Anubys6/ExpendeX-Smart-Vending-FIME/06_RENDERS_OFICIALES_Y_COMERCIALES/Img16_CAD_Fusion360_Vista_Posterior_Matriz_Motorreductores_Cableado.png

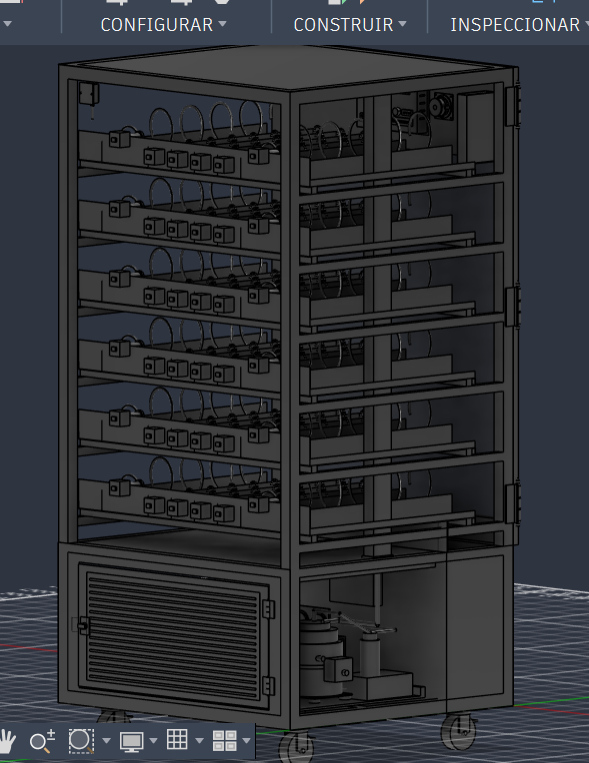
06_RENDERS_OFICIALES_Y_COMERCIALES/Img16_CAD_Fusion360_Vista_Posterior_Matriz_Motorreductores_Cableado.png
