Anubys6/ExpendeX-Smart-Vending-FIME/05_PLATAFORMA_WEB_DUAL/user_interface_admin/images/coca_cola_sin_azucar.jpg

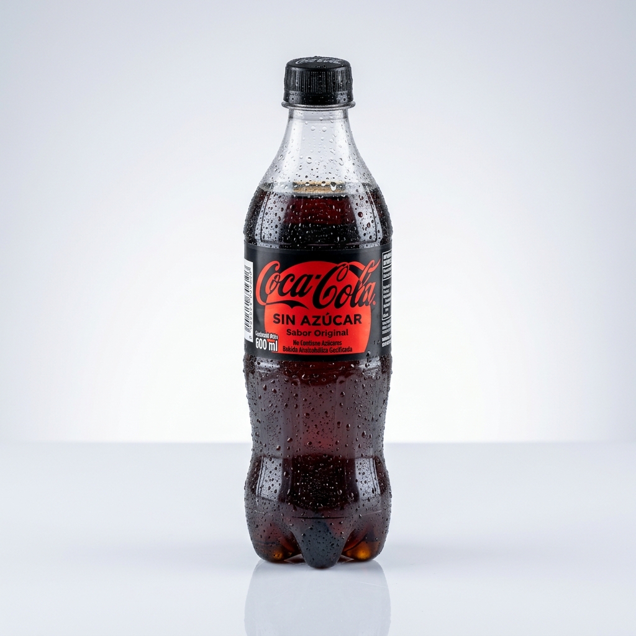
05_PLATAFORMA_WEB_DUAL/user_interface_admin/images/coca_cola_sin_azucar.jpg
