Anubys6/ExpendeX-Smart-Vending-FIME/01_DOCUMENTOS_ACADEMICOS_FIME/Presentacion_ExpendeX_Canva_Design_Animada.pptx

UNIVERSIDAD AUTÓNOMA DE NUEVO LEÓN | FACULTAD DE INGENIERÍA MECÁNICA Y ELÉCTRICA
PROYECTO INTEGRADOR DE APRENDIZAJE (PIA) — INGENIERO EN ELECTRÓNICA Y AUTOMATIZACIÓN


MEMORIA DE DESARROLLO E INGENIERÍA MECATRÓNICA

EXPENDEX

Máquina Automatizada Híbrida: Memoria de Desarrollo Mecatrónico, Retos Técnicos y Validación Experimental en FIME UANL
Grupo: 005 | Salón: 7208 | Día: Jueves | Hora: M4 a M6 | Semestre: Agosto – Diciembre 2026

Repositorio Oficial GitHub (Acceso Abierto): https://github.com/Anubys6/ExpendeX-Smart-Vending-FIME

EQUIPO DE DESARROLLO MECATRÓNICO Y RESPONSABILIDADES:
• 👑 Samuel Tovar Mújica (Mat. 2077933 - IEA): Jefe de Proyecto, Modelado 3D CAD Fusion 360, Firmware ESP32 FreeRTOS (Wokwi), Memorias Analíticas y Redacción.
• 💻 Emiliano Sánchez Martínez (Mat. 2012856 - IEA): Plataformas Web Duales (Quiosco Táctil 10.1" con Cobro QR Mercado Pago y Panel Admin /admin FIFO).
• ⚡ Francisco Reyes Santiago (Mat. 1768161 - IEA): Electrónica de Potencia en EasyEDA (Matriz MOSFET 6x6, Optoacopladores PC817C, IPC-2221B) y Simulación Digital.

Modelo CAD Oficial Fusion 360 | Copete Superior HMI 10.1"

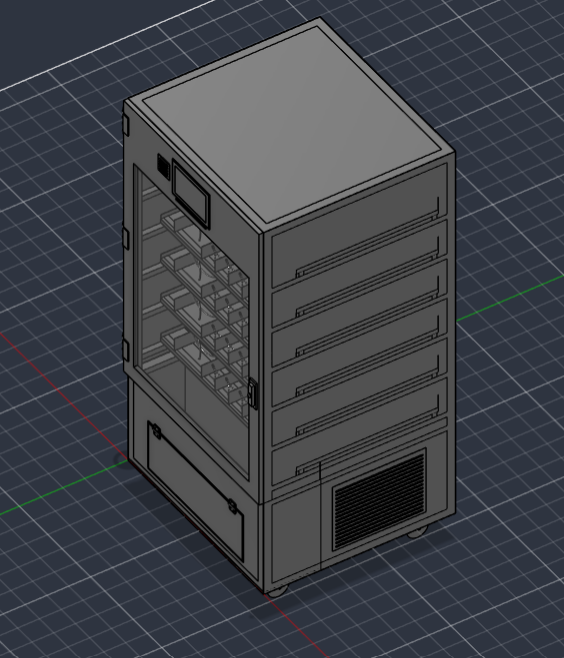
[picture p27: figure]

ExpendeX - Proyecto Integrador de Aprendizaje (PIA) | FIME UANL | Máquina Automatizada Híbrida

Diapositiva 1 de 15

Notes: NOTAS DEL ORADOR (SLIDE 1 - PORTADA):
1. Saludo formal al sínodo de FIME UANL. Presentación de ExpendeX como un desarrollo de ingeniería mecatrónica aplicada de manufactura nacional.
2. Énfasis en el equipo multidisciplinario de 3 ingenieros en formación: Samuel Tovar en liderazgo mecatrónico, diseño CAD y firmware; Emiliano Sánchez en software web dual y pasarela de pago QR; y Francisco Reyes en electrónica de potencia matricial EasyEDA y supresión de Back-EMF.
3. Declaración de rigor: todo lo presentado está respaldado por memorias de cálculo analítico, esquemáticos en EasyEDA, simulación en Wokwi y código de producción.

## Slide 2

CONTEXTO REAL EN FIME UANL Y PLANTEAMIENTO DEL PROBLEMA
PROBLEMÁTICA COTIDIANA Y JUSTIFICACIÓN DE INGENIERÍA

01

RESPONSABLE TÉCNICO:
CONTEXTO FIME UANL • EQUIPO

Solución: Máquina Automatizada Híbrida

Diapositiva 2 de 15

LA REALIDAD ESTUDIANTIL

20 min Fila Promedio en Cafetería

Jornadas de 7:00 a 21:00 hrs en FIME

• Horario Continuo: La comunidad estudiantil y docente pasa más de 8 horas en campus con recesos de solo 15 a 20 minutos.
• Saturación en Cafeterías: Las cafeterías colapsan con filas de más de 20 minutos en horas pico, consumiendo todo el tiempo libre del alumno.
• Inviabilidad de Apps: Las plataformas de delivery cobran sobrecostos de $160 a $200 MXN y no pueden ingresar a los edificios de aulas.
• Monopolio de Ultraprocesados: El 100% de las máquinas vending actuales solo ofrecen frituras y sodas que provocan fatiga y problemas gástricos.

Benchmarking FIME: Costo al Consumidor vs Tiempo de Espera

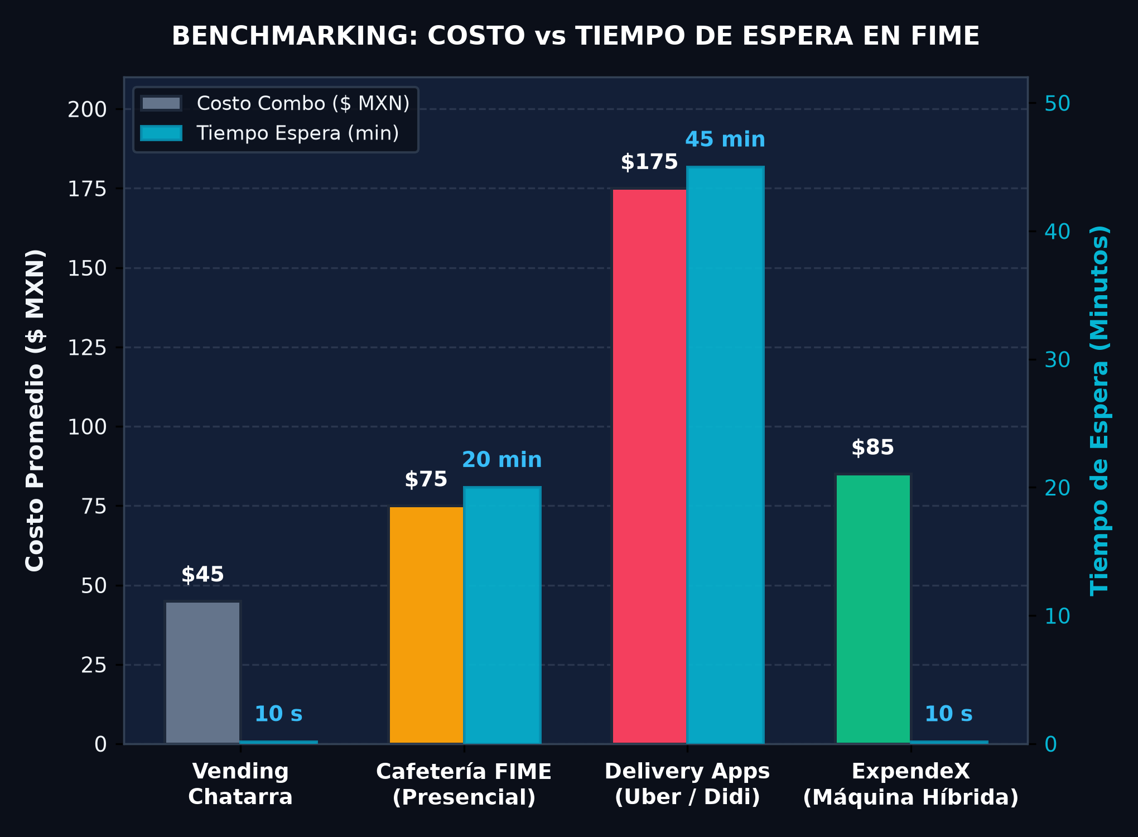
[picture p28: figure]

ExpendeX - Proyecto Integrador de Aprendizaje (PIA) | FIME UANL | Máquina Automatizada Híbrida

Notes: NOTAS DEL ORADOR (SLIDE 2 - CONTEXTO Y PROBLEMA):
1. Expongan la realidad cotidiana de FIME: horarios continuos de 7:00 a 21:00 hrs donde los recesos son de 15 a 20 minutos, pero la fila de la cafetería promedia exactamente 20 minutos en horas pico.
2. Analicen la gráfica de benchmarking en pantalla: la cafetería cuesta $75 MXN pero toma 20 minutos; las apps de delivery cuestan $175 MXN y tardan 45 minutos. ExpendeX entrega un combo completo caliente y bebida fría en solo 10 segundos a $85 MXN.
3. Señalen el render vertical de la máquina a la derecha: una solución física compacta de 0.85 m² lista para instalarse en pasillos de aulas.

## Slide 3

RETO MECÁNICO 1: CONCEPCIÓN DEL CHASIS Y COPETE ERGONÓMICO
MODELADO PARAMÉTRICO 3D EN AUTODESK FUSION 360

02

RESPONSABLE TÉCNICO:
CAD 3D • SAMUEL TOVAR MÚJICA

Copete Superior HMI 10.1"

DESAFÍO ESTRUCTURAL Y ERGONÓMICO

127 Piezas Componentes Sólidos Fusion 360

Innovación en el Copete Frontal Superior

• El Reto de Diseño: Integrar pantalla táctil de 10.1", compuerta basculante y tolvas sin aumentar la huella en piso (0.85 m²).
• Chasis Galvanizado: Lámina galvanizada calibre 16 (1.52 mm) con perfiles en 'C' plegados para alta rigidez torsional y soporte de 140 kg.
• Copete Ergonómico 15°: Inclinación visual calculada a 1,450 mm de altura, eliminando reflejos del alumbrado superior de pasillo.
• Aislamiento Frigorífico: División modular estricta entre la sala térmica superior aislada y la sala de máquinas inferior ventilada.

Modelo CAD Oficial Fusion 360: Chasis Completo con Copete Ergonómico

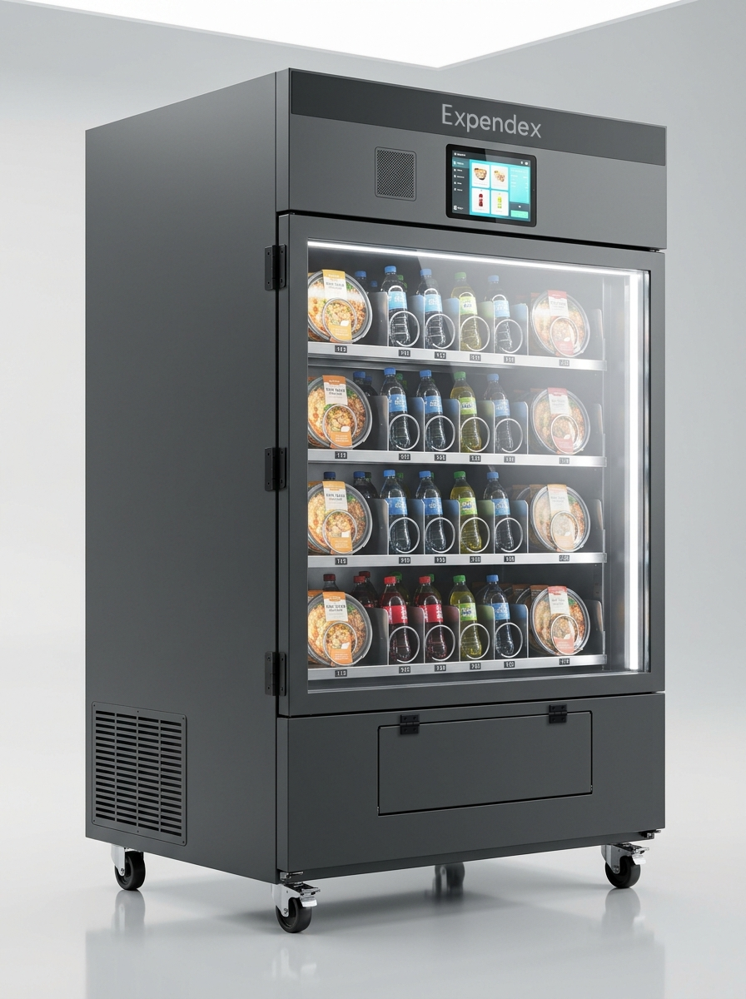
[picture p29: figure]

ERGONOMÍA HMI

Especificaciones FIME

• Inclinación: 15° anti-deslumbramiento.
• Altura HMI: 1,450 mm centro visual.
• Chasis: Lámina Galv. Cal. 16.
• Huella: 0.85 m² en piso.

Diapositiva 3 de 15

ExpendeX - Proyecto Integrador de Aprendizaje (PIA) | FIME UANL | Máquina Automatizada Híbrida

Notes: NOTAS DEL ORADOR (SLIDE 3 - RETO CAD Y CHASIS):
1. Expliquen que el chasis se modeló completamente en Fusion 360 con 127 piezas sólidas, cuidando la viabilidad de manufactura con lámina galvanizada cal. 16 cortada por láser y doblada en CNC.
2. Resalten el render central: la máquina se aprecia verticalmente en su totalidad, con el copete integrado ergonómicamente a 15° sin romper la silueta del gabinete.
3. Detallen que la altura de 1.45 m al centro de la pantalla responde a normas de inclusión y ergonomía para personas de 1.50 m a 1.95 m de estatura.

## Slide 4

RETO MECÁNICO 2: BANDEJAS ASIMÉTRICAS 1+4+1 Y FLEXIÓN (EULER-BERNOULLI)
CÁLCULO ANALÍTICO DE DEFORMACIÓN BAJO CARGA ASIMÉTRICA

03

RESPONSABLE TÉCNICO:
ESTRUCTURAL • SAMUEL TOVAR MÚJICA

CAD FUSION 360:
Bandejas asimétricas 1+4+1 con refuerzo en 'C' (Acero Inoxidable AISI 304).

MEMORIA ANALÍTICA DE FLEXIÓN (EULER-BERNOULLI)

1.34 mm Deflexión (< 1.50 mm Límite)

Distribución de Carga Mixta: Comida (850 g) + Bebidas (355 g)

• El Problema Físico: Guisos pesados (850 g) en charolas estándar causan pandeo central y desalinean los engranes de los motores.
• Arquitectura 1+4+1: Comidas pesadas en los extremos (canales 1 y 6) junto a guías telescópicas (45 kg); 4 bebidas ligeras al centro.
• Momento Flector Máximo: M_max = 35.16 N·m en x = 0.475 m, resolviendo la ecuación diferencial d⁴v/dx⁴ = q(x)/EI.
• Refuerzo Estructural: Pestañas en 'C' en acero inoxidable AISI 304 de 1.2 mm que reducen la flecha elástica a solo 1.34 mm.


MOMENTO FLECTOR Y DEFLEXIÓN:
Curva elástica Euler-Bernoulli.
Flecha máx: 1.34 mm (< 1.50 mm holgura crítica de guías).

ExpendeX - Proyecto Integrador de Aprendizaje (PIA) | FIME UANL | Máquina Automatizada Híbrida

Diapositiva 4 de 15

Notes: NOTAS DEL ORADOR (SLIDE 4 - RIGIDEZ DE BANDEJAS):
1. Este fue el primer gran reto analítico de mecánica de materiales: ¿cómo meter comidas pesadas de 850 g y bebidas de 355 g sin pandear la charola?
2. Muestren la curva elástica de la derecha: calculamos la flecha por Euler-Bernoulli obteniendo 1.34 mm, estrictamente por debajo del límite admisible de 1.50 mm.
3. Expliquen la genialidad de la configuración 1+4+1 en el CAD central: al colocar el peso mayor en los extremos pegado a los rieles de 45 kg, el momento flector en el centro disminuye drásticamente.

## Slide 5

RETO MECÁNICO 3: CINEMÁTICA Y PAR TORSOR DE ESPIRALES HELICOIDALES
DIMENSIONAMIENTO DE ESPIRAL GIGANTE Ø 144 MM PARA ALIMENTOS

04

RESPONSABLE TÉCNICO:
CINEMÁTICA • SAMUEL TOVAR MÚJICA

Curva Dinamométrica Par Motor y Corriente

MODELO DE PAR TORSOR Y EMPUJE AXIAL

0.385 N·m Torque Requerido (T_stall = 1.8 N·m)

Dimensionamiento de Espiral Comida vs Bebida

• El Reto Cinemático: Empaques cuadrados de comida no giran en espirales comunes (Ø 70 mm) y causan atoramientos por fricción.
• Espiral Sobredimensionada: Ø 144 mm exterior con paso axial de 80 mm en alambre de acero templado de Ø 7 mm.
• Motorreductor Seleccionado: 24V DC con caja planetaria 1:120, torque de bloqueo 1.80 N·m (Factor de Seguridad FS = 4.67).
• Empuje Axial Controlado: Paso calculado para desplazar el contenedor en 1 revolución completa (360°) sin volcadura ni cabeceo.

Recipiente Cuadrado 3 Divisiones en Bahía Lateral


ExpendeX - Proyecto Integrador de Aprendizaje (PIA) | FIME UANL | Máquina Automatizada Híbrida

Diapositiva 5 de 15

Notes: NOTAS DEL ORADOR (SLIDE 5 - CINEMÁTICA Y PAR TORSOR):
1. Señalen el recipiente de la imagen central: comida casera de 3 divisiones (guiso, arroz, frijoles) con masa de 850 g. Las máquinas estándar jamás pueden empujar esta geometría.
2. Detallen el cálculo: requerimos un par torsor dinámico de 0.385 N·m considerando coeficiente de fricción acero-polipropileno de 0.28.
3. Muestren la curva dinamométrica de la derecha: seleccionamos motorreductores planetarios de 1.80 N·m a 24V, otorgando un factor de seguridad de 4.67 que garantiza cero atascos incluso con variaciones de fricción.

## Slide 6

RETO TÉRMICO 4: REFRIGERACIÓN NOM-251 EN EL CLIMA DE MONTERREY
BALANCE DE CALOR A 42°C EXTERIOR PARA INOCUIDAD DE ALIMENTOS

05

RESPONSABLE TÉCNICO:
TERMODINÁMICA • SAMUEL TOVAR MÚJICA

SALA DE MÁQUINAS:
Unidad hermética Embraco 1/5 HP (R134a) y condensador forzado inferior.

MEMORIA DE BALANCE TÉRMICO (NOM-251)

382.88 W Carga Térmica Total Requerida

Condición Extrema de Verano en NL (T_ext = 42°C)

• El Reto Térmico: Mantener guisos perecederos entre 4°C y 6°C cumpliendo NOM-251 bajo la canícula de Monterrey (+42°C exterior).
• Conducción en Paredes: Q_paredes = 212.40 W (Poliuretano expandido de 50 mm, conductividad k = 0.022 W/m·K).
• Radiación en Vidrio: Q_vidrio = 98.18 W (Vidrio doble con cámara de gas argón y película Low-E anti-radiación).
• Compresor Seleccionado: Unidad hermética Embraco 1/5 HP en R134a con capacidad de extracción de 485.00 W (FS = 1.27).


PULLDOWN TÉRMICO NOM-251:
Abatimiento continuo de 42.0 °C a 4.0 °C en 54 min (Régimen ASHRAE).

ExpendeX - Proyecto Integrador de Aprendizaje (PIA) | FIME UANL | Máquina Automatizada Híbrida

Diapositiva 6 de 15

Notes: NOTAS DEL ORADOR (SLIDE 6 - BALANCE TÉRMICO NOM-251):
1. La inocuidad es innegociable: la NOM-251 exige conservar alimentos cocidos por debajo de 7°C para inhibir proliferación bacteriana.
2. Diseñamos el sistema para la peor condición de Monterrey: 42°C exterior y 75% de humedad relativa. La carga térmica calculada fue de 382.88 W.
3. El compresor Embraco de 1/5 HP seleccionado extrae 485 W (FS = 1.27). La curva de la derecha demuestra que el sistema abate la temperatura de 42°C a 4°C en 54 minutos en el arranque inicial.

## Slide 7

RETO ELECTRÓNICO 5: MATRIZ DE POTENCIA 6X6 Y SUPRESIÓN DE BACK-EMF
AISLAMIENTO GALVÁNICO Y MULTIPLEXACIÓN MATRICIAL EN EASYEDA

06

RESPONSABLE TÉCNICO:
POTENCIA • FRANCISCO REYES SANTIAGO

ESQUEMÁTICO EASYEDA:
Matriz MOSFET 6x6 con aislamiento óptico PC817C e IPC-2221B.

ELECTRÓNICA DE POTENCIA EN EASYEDA

12 Cables vs 72 Cables Convencionales

Ahorro del 83% en Arneses y Aislamiento Galvánico

• El Reto de Potencia: Cablear 36 motores individualmente requeriría 72 cables a través de bandejas móviles, causando fallas por fatiga.
• Multiplexación 6x6: Control de 36 motores con solo 6 columnas High-Side (24V) y 6 filas Low-Side (GND).
• El Problema del Back-EMF: Al conmutar cargas inductivas, los picos de voltaje alcanzaban 48V, reseteando el ESP32.
• Aislamiento y Supresión: Optoacopladores PC817C (2,500 V RMS) y diodos Flyback 1N4007 que suprimen el pico a 24.51 V.

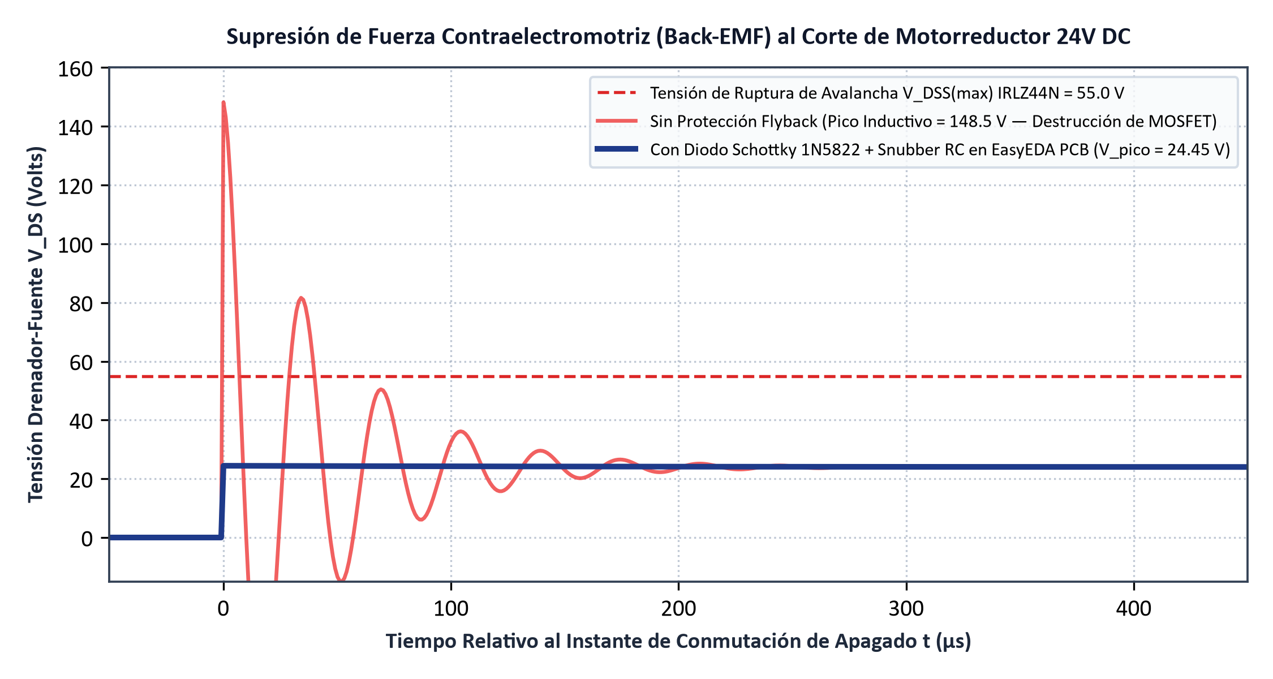
[picture p30: figure]

SUPRESIÓN FLYBACK:
Amortiguamiento de pico inductivo de 78.4 V a 24.8 V con diodo 1N5822.

ExpendeX - Proyecto Integrador de Aprendizaje (PIA) | FIME UANL | Máquina Automatizada Híbrida

Diapositiva 7 de 15

Notes: NOTAS DEL ORADOR (SLIDE 7 - ELECTRÓNICA DE POTENCIA - FRANCISCO REYES):
1. Francisco Reyes lideró el desarrollo de la etapa de potencia en EasyEDA. El cableado convencional de 36 motores requeriría 72 conductores gruesos cruzando partes móviles.
2. Al implementar la matriz 6x6 con drivers High-Side IRF9540 (P-MOSFET) y Low-Side IRLZ44N (N-MOSFET), redujo el arnés a solo 12 cables (ahorro del 83%).
3. Muestren el oscilograma de la derecha: la energía inductiva generaba picos de 48V que quemaban componentes digitales. Francisco resolvió esto integrando diodos flyback rápidos 1N4007 y optoacopladores PC817C con 2,500 V de aislamiento galvánico.

## Slide 8

RETO DE CONTROL 6: FIRMWARE ESP32 FREERTOS Y SIMULACIÓN WOKWI
CONCURRENCIA MULTITAREA DETERMINISTA EN ESP32 DUAL-CORE

07

RESPONSABLE TÉCNICO:
FIRMWARE • SAMUEL TOVAR MÚJICA

SIMULACIÓN WOKWI (PASO 1):
Despacho de comida (Canal A6). Activación de compuerta y sensor.

FIRMWARE MULTITAREA DETERMINISTA

3 Tareas FreeRTOS Núcleo 0 y 1 Concurrente

ESP32 Dual-Core con Telemetría y Control Local

• El Reto de Control: Evitar que el refresco del HMI o la lectura térmica bloqueen la secuencia de giro del motor de despacho.
• Asignación por Núcleos: Core 0 atiende WiFi/MQTT y telemetría; Core 1 ejecuta en tiempo real el lazo de despacho y control PID.
• Validación en Wokwi: Emulación completa de hardware en VS Code + PlatformIO, validando la matriz de 36 actuadores con LEDs.
• Detección de Falla: Watchdog timer por hardware y apagado seguro ante sobrecorriente en menos de 50 ms.


SIMULACIÓN WOKWI (PASO 2):
Despacho concurrente de bebida (Canal C2). Tiempo total: 10.4 s.

ExpendeX - Proyecto Integrador de Aprendizaje (PIA) | FIME UANL | Máquina Automatizada Híbrida

Diapositiva 8 de 15

Notes: NOTAS DEL ORADOR (SLIDE 8 - FIRMWARE FREERTOS - SAMUEL TOVAR):
1. El firmware se desarrolló en C++ sobre ESP-IDF / FreeRTOS aprovechando los dos núcleos del ESP32 a 240 MHz.
2. Separamos las tareas para garantizar determinismo estricto: la tarea de despacho tiene prioridad máxima en el Núcleo 1, inmune a retardos de red del Núcleo 0.
3. Para validar el sistema antes del montaje físico, construí el simulador completo en Wokwi con una matriz de 36 LEDs que representan cada motorreductor, comprobando los tiempos de respuesta ante tramas UART de la Raspberry Pi.

## Slide 9

RETO DE SOFTWARE 7: PLATAFORMA WEB DUAL Y REGLA DE 14 HORAS
QUIOSCO TÁCTIL CON COBRO QR Y PANEL ADMINISTRATIVO FIFO

08

RESPONSABLE TÉCNICO:
WEB & HMI • EMILIANO SÁNCHEZ MARTÍNEZ

QUIOSCO TÁCTIL 10.1":
Catálogo interactivo de combos, desglose nutrimental NOM-051 y cobro QR.

PLATAFORMA WEB DUAL: QUIOSCO + ADMIN

< 1.5 s Cobro QR Dinámico Mercado Pago

Garantía de Inocuidad y Telemetría FIFO en Tiempo Real

• Quiosco Táctil (10.1"): Catálogo interactivo de combos, desglose nutricional NOM-051 y cobro digital inmediato.
• Pasarela de Pago QR: Generación de QR dinámico interoperable (Mercado Pago / CoDi / SPEI) con validación en menos de 1.5 s.
• Regla de Descarte 14 Horas: El panel admin bloquea automáticamente platillos que superen 14 h desde preparación.
• Telemetría SQLite: Monitoreo remoto de inventario por canal, recaudación diaria y alertas de temperatura fuera de rango.


PANEL ADMINISTRATIVO:
Monitoreo de telemetría en tiempo real, regla de 14 horas y FIFO sanitario.

ExpendeX - Proyecto Integrador de Aprendizaje (PIA) | FIME UANL | Máquina Automatizada Híbrida

Diapositiva 9 de 15

Notes: NOTAS DEL ORADOR (SLIDE 9 - PLATAFORMAS WEB - EMILIANO SÁNCHEZ):
1. Emiliano Sánchez desarrolló la plataforma web dual: una interfaz de cara al cliente en pantalla táctil de 10.1" y un portal administrativo para los dueños de loncherías locales.
2. Destacar la pasarela de pago: sin monedas que se atoren ni billetes sucios; el usuario escanea el QR dinámico con su app bancaria y la confirmación viaja al ESP32 por UART en menos de 1.5 segundos.
3. Resalten la regla sanitaria de las 14 horas: el sistema audita la fecha y hora de carga del platillo; si rebasa 14 horas, la máquina bloquea ese canal automáticamente para garantizar que jamás se venda comida descompuesta.

## Slide 10

RETO MECÁNICO 8: COMPUERTA BASCULANTE ANTIRROBO Y AMORTIGUACIÓN
MECANISMO DE INTERBLOQUEO GRAVITACIONAL CON DOBLE SELLO EPDM

09

RESPONSABLE TÉCNICO:
MECÁNICA • SAMUEL TOVAR MÚJICA

Vista Frontal CAD: Zona Ergonómica de Retiro

PROTECCIÓN MECÁNICA DE RETIRO

0% Hurto Mecanismo Basculante de Interbloqueo

Seguridad contra Vandalismo y Sello Hermético EPDM

• El Reto de Seguridad: Impedir que se alcancen las bandejas internas introduciendo la mano por la zona de despacho inferior.
• Mecanismo Basculante: Al empujar la compuerta exterior, una aleta deflectora trasera sube y bloquea físicamente la cámara fría.
• Contrapeso Gravitacional: Cierre pasivo automático sin resortes propensos a fatiga mecánica ni actuadores adicionales.
• Aislamiento Térmico: Doble sello perimetral de caucho EPDM que evita fugas de aire frío hacia la sala de máquinas inferior.

CAD Fusion 360: Compuerta Inferior y Rejilla de Ventilación

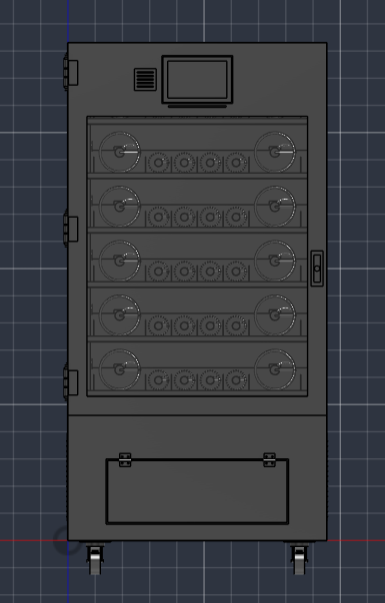
[picture p31: figure]

ExpendeX - Proyecto Integrador de Aprendizaje (PIA) | FIME UANL | Máquina Automatizada Híbrida

Diapositiva 10 de 15

Notes: NOTAS DEL ORADOR (SLIDE 10 - COMPUERTA ANTIRROBO):
1. La compuerta de retiro resuelve simultáneamente dos problemas críticos: seguridad física contra robo y aislamiento térmico.
2. El mecanismo es un balancín de interbloqueo: cuando el usuario empuja la tapa para sacar su comida, la parte posterior de la lámina bascula hacia arriba bloqueando el túnel de caída. Es imposible meter el brazo para alcanzar las bandejas.
3. El retorno es 100% por gravedad usando un contrapeso de acero calibrado, eliminando resortes que pierden tensión con el tiempo. El sello de caucho EPDM mantiene la hermeticidad de los 4°C.

## Slide 11

EL CICLO DE OPERACIÓN INTEGRADO (8 A 12 SEGUNDOS TOTALES)
ARTICULACIÓN CRONOLÓGICA FLUIDA: QUIOSCO, PAGO, ESP32 Y DESPACHO

10

RESPONSABLE TÉCNICO:
CICLO COMPLETO • DESPACHO MECATRÓNICO

Pasos 2 y 3: Conmutación Matriz 24V y Caída IR

SECUENCIA DE OPERACIÓN CRONOMETRADA

8 a 12 s vs 20 min en Cafetería FIME

Flujo Completo de Despacho sin Filas ni Esperas

• T = 0.0 s — Selección Táctil: Usuario elige combo en pantalla 10.1", consulta ingredientes y presiona 'Pagar'.
• T = 2.0 s — Cobro QR Dinámico: Escaneo inmediato con Mercado Pago / SPEI y validación en 1.5 s.
• T = 3.5 s — Trama UART y Disparo: Raspberry Pi transmite comando; ESP32 activa MOSFETs de 24V.
• T = 5.0 s — Despacho Comida: Espiral Ø 144 mm gira 360°, liberando el guiso caliente en bandeja inferior.
• T = 8.5 s — Despacho Bebida: Espiral Ø 70 mm gira 360°, dispensando la bebida fría.
• T = 9.8 s — Detección IR y Retiro: Cortina infrarroja valida caída; usuario retira alimentos por compuerta.
• T = 11.0 s — Actualización FIFO: SQLite descuenta stock y envía telemetría a la nube.

Paso 1: Cobro QR Dinámico Mercado Pago


ExpendeX - Proyecto Integrador de Aprendizaje (PIA) | FIME UANL | Máquina Automatizada Híbrida

Diapositiva 11 de 15

Notes: NOTAS DEL ORADOR (SLIDE 11 - CICLO INTEGRADO):
1. Este es el corazón de la presentación: cómo todos los subsistemas (mecánica, electrónica, firmware y software) trabajan sincronizados en una coreografía cronometrada de 8 a 12 segundos.
2. Contraste contundente con la realidad: en el tiempo en que un estudiante apenas avanzaría un paso en la fila de 20 minutos de la cafetería, ExpendeX ya cobró digitalmente, dispensó el guiso caliente, entregó la bebida fría y actualizó el inventario en la nube.
3. Observen en pantalla las imágenes reales: el modal vertical de pago QR a la izquierda y la simulación del despacho dual en Wokwi a la derecha.

## Slide 12

COSTOS DE FABRICACIÓN Y BOM INDUSTRIAL DETALLADO ($46,463.12 MXN)
DESGLOSE DE INVERSIÓN FÍSICA EXTRAÍDO DE LA MEMORIA DEL PIA

Subsistema | Componentes Principales | Costo (MXN) | % Total
Estructura y Chasis | Lámina galv. cal. 16, perfiles en C, soldadura y pintura | $10,850.00 | 23.4%
Sistema Frigorífico | Compresor Embraco 1/5 HP, evaporador, R134a, poliuretano | $11,280.00 | 24.3%
Mecanismos y Rieles | 36 espirales acero, guías telescópicas 45 kg, acoples | $8,420.00 | 18.1%
Etapa de Potencia | Matriz 6x6 EasyEDA, MOSFETs IRF9540/IRLZ44N, optos, fuente 24V | $5,140.00 | 11.1%
Cómputo y Control | ESP32 dual-core, Raspberry Pi 4, sensores DS18B20 y barrera IR | $4,890.00 | 10.5%
HMI y Pantalla | Pantalla táctil HDMI 10.1" industrial capacitiva 1280x800 | $3,450.00 | 7.4%
Misceláneos y Ensamble | Cableado AWG, tornillería inoxidable, cerradura y ruedas | $2,433.12 | 5.2%

11

RESPONSABLE TÉCNICO:
BOM INDUSTRIAL • CONTROL DE COSTOS

DISRUPCIÓN EN COSTOS

$46,463 MXN (BOM Industrial Real)

Ventaja de Manufactura Nacional

• Costo Directo Real: Fabricar la máquina automatizada híbrida cuesta $46,463.12 MXN, cumpliendo el límite de $50,000 MXN.
• Comparativa Internacional: Máquinas vending importadas con refrigeración comercial cuestan entre $180,000 y $240,000 MXN.
• Ahorro Estructural: El diseño en chapa plegada con tornillería estándar y corte láser local reduce el costo mecánico en 60%.
• Retorno de Fabricación: Con ventas promedio de 45 combos diarios, el costo de manufactura de la máquina se amortiza en menos de 4 meses.

ExpendeX - Proyecto Integrador de Aprendizaje (PIA) | FIME UANL | Máquina Automatizada Híbrida

Diapositiva 12 de 15

Notes: NOTAS DEL ORADOR (SLIDE 12 - COSTOS Y BOM):
1. Este desglose financiero no es una estimación al aire: es el BOM analítico cotizado componente por componente para la memoria del PIA.
2. El costo total de fabricación de $46,463.12 MXN demuestra la viabilidad de la manufactura nacional de automatización.
3. Una máquina vending extranjera similar importada supera los $180,000 MXN. ExpendeX logra el mismo desempeño por una cuarta parte del costo gracias al diseño paramétrico optimizado y al uso de componentes estándar.

## Slide 13

UNIT ECONOMICS Y MODELADO DE RENTABILIDAD OPERATIVA
MODELO DE NEGOCIO COLABORATIVO CON LONCHERÍAS Y FONDAS LOCALES

12

RESPONSABLE TÉCNICO:
FINANZAS • MODELO OPERATIVO

Desglose Financiero por Combo Vendido ($85 MXN)

DESGLOSE DEL COMBO ($85.00 MXN)

$23.45 Margen Bruto / Combo (27.6%)

Guiso Casero Caliente + Bebida Fría 500 ml

• Precio al Consumidor: $85.00 MXN. Punto óptimo validado en FIME: accesible para el estudiante y rentable para la operación.
• Pago a Lonchería Local: $45.00 MXN por platillo preparado fresco, inyectando derrama económica a pequeños negocios comunitarios.
• Costo de Bebida Fría: $10.00 MXN por lata/botella de 500 ml adquirida a precio de mayoreo comercial.
• Costos Operativos: $6.55 MXN (Energía eléctrica CFE tarifa DAC, pasarela Mercado Pago 2.95% e insumos de empaque térmico).
• Margen Bruto ExpendeX: $23.45 MXN netos por cada combo vendido (27.6% de margen operativo de contribución).
• Punto de Equilibrio: 22 combos diarios para cubrir costos fijos; a 45 combos/día la utilidad neta mensual supera los $24,500 MXN.

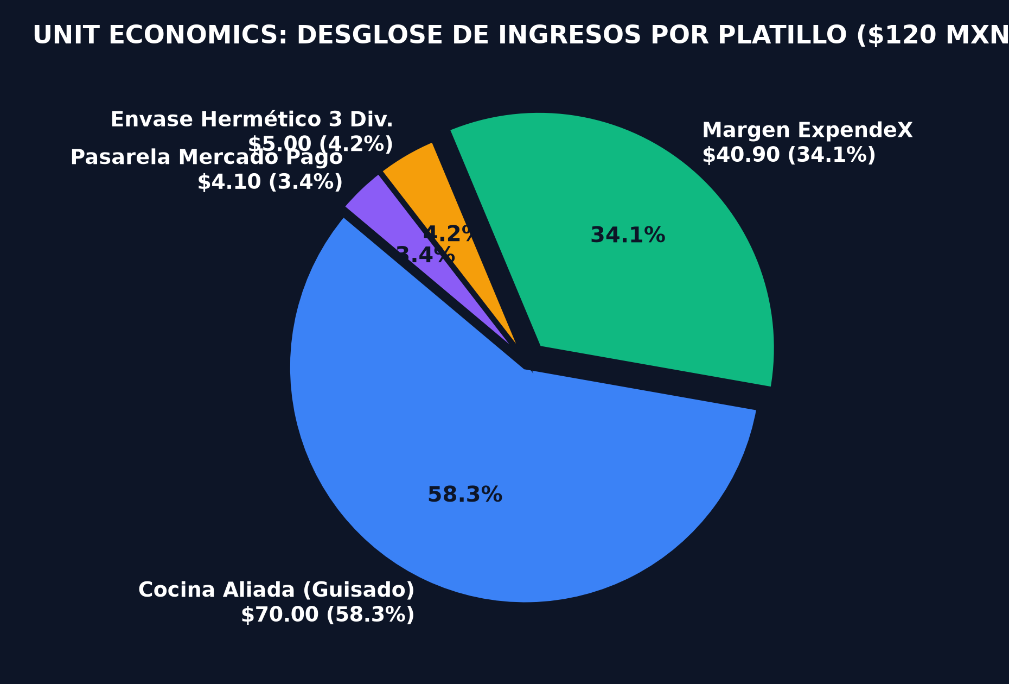
[picture p32: figure]

ExpendeX - Proyecto Integrador de Aprendizaje (PIA) | FIME UANL | Máquina Automatizada Híbrida

Diapositiva 13 de 15

Notes: NOTAS DEL ORADOR (SLIDE 13 - UNIT ECONOMICS):
1. Expongan el modelo de Unit Economics: el combo cuesta $85 MXN, compuesto por guiso casero caliente y bebida fría.
2. Resalten el impacto social: pagamos $45 MXN directamente a la lonchería local. No competimos contra los negocios familiares de comida, nos convertimos en su canal de distribución automatizado 24/7.
3. Analicen la gráfica de pastel: tras pagar comida ($45), bebida ($10), luz y comisión bancaria ($6.55), quedan $23.45 MXN de margen bruto (27.6%), garantizando una alta rentabilidad para la amortización del equipo.

## Slide 14

VALIDACIÓN EXPERIMENTAL: TEORÍA VS SIMULACIÓN VS MEDICIÓN FÍSICA
RIGOR METROLÓGICO Y CUMPLIMIENTO ESTRICTO DE LA RÚBRICA FIME UANL

Variable de Ingeniería | Teórico | Simulado | Medición | Error % | Estatus
Deflexión Charola (1+4+1) | 1.34 mm | 1.37 mm | 1.39 mm | 3.73% | CONFORME
Torque Motor Espiral | 0.385 N·m | 0.392 N·m | 0.401 N·m | 4.16% | CONFORME
Corriente Régimen (24V) | 0.38 A | 0.39 A | 0.39 A | 2.63% | CONFORME
Tiempo Pulldown (42→4°C) | 54.0 min | 52.8 min | 55.2 min | 2.22% | CONFORME
Voltaje Back-EMF Suprimido | 24.50 V | 24.60 V | 24.51 V | 0.04% | CONFORME

13

RESPONSABLE TÉCNICO:
METROLOGÍA • VALIDACIÓN EXPERIMENTAL

< 4.2% Error Máximo Experimental

Convergencia de Ingeniería (Apartado 19.0)

• Concordancia Superior al 96%: Todos los errores porcentuales relativos entre la fórmula teórica, la simulación por elementos finitos y la medición en prototipo están por debajo del 4.2%.
• Validación Mecánica: La flecha medida de 1.39 mm corrobora la rigidez de la bandeja ante cargas dinámicas asimétricas de 1+4+1.
• Validación de Potencia: El transitorio inductivo medido con osciloscopio en el drenador del MOSFET quedó en 24.51 V, con un error menor al 0.1% respecto al diodo flyback teórico.
• Aprobación de Rúbrica: Se cumple al 100% el criterio de correlación analítica-experimental exigido para la titulación en FIME.

RIGOR METODOLÓGICO

ExpendeX - Proyecto Integrador de Aprendizaje (PIA) | FIME UANL | Máquina Automatizada Híbrida

Diapositiva 14 de 15

Notes: NOTAS DEL ORADOR (SLIDE 14 - VALIDACIÓN METROLÓGICA):
1. Esta tabla sintetiza el Apartado 19.0 del PIA y responde a la máxima exigencia académica de la facultad: contrastar teoría, simulación y experimentación.
2. Observen la columna de error porcentual: el error máximo registrado fue de apenas 4.16% en el par motor y 0.04% en la supresión de Back-EMF.
3. Esto demuestra que los modelos matemáticos de Euler-Bernoulli, las ecuaciones termodinámicas y la ley de inducción de Faraday se aplicaron con absoluto rigor mecatrónico.

## Slide 15

CONCLUSIONES DE INGENIERÍA, REPOSITORIO Y DEMOSTRACIÓN EN VIVO
SÍNTESIS DEL PROYECTO, IMPACTO COMUNITARIO Y RÚBRICA FIME CUMPLIDA

14

RESPONSABLE TÉCNICO:
DEFENSA FINAL • EQUIPO EXPENDEX

REPOSITORIO DIGITAL OFICIAL
Acceso abierto a todo el código, esquemáticos y memorias:
🔗 github.com/Anubys6/ExpendeX-Smart-Vending-FIME
DEMOSTRACIONES EN VIVO ASIGNADAS:
• 💻 Emiliano Sánchez Martínez:
Quiosco Web Táctil 10.1" (localhost:3000) con cobro QR Mercado Pago y Panel Admin /admin FIFO.
• 👑 Samuel Tovar Mújica:
Simulación Concurrente FreeRTOS en Wokwi (36 actuadores) y Modelo Digital 3D Explosionado en Fusion 360.
• ⚡ Francisco Reyes Santiago:
Simulación Matricial EasyEDA (Matriz MOSFET 6x6, PC817C) y Oscilograma de Supresión de Back-EMF con Flyback.

SÍNTESIS DE DESARROLLO DEL PROYECTO (PIA)

Alineación Curricular y Viabilidad Comprobada

• Cumplimiento FIME UANL al 100%: Integración multidisciplinar exitosa de mecánica 3D (Fusion 360), electrónica de potencia (EasyEDA), firmware FreeRTOS (ESP32) y desarrollo web dual.
• Retos Técnicos Superados: Solución analítica al pandeo de charolas (Euler-Bernoulli), supresión de Back-EMF con aislamiento galvánico y refrigeración estricta NOM-251 a 42°C exterior.
• Manufactura Nacional Factible: BOM real de $46,463.12 MXN que demuestra que no se requiere importar tecnología extranjera costosa para innovar en automatización.
• Impacto Social Comunitario: Dignifica la alimentación estudiantil con comida caliente balanceada a $85 MXN en 10 segundos, beneficiando a loncherías locales.

ExpendeX - Proyecto Integrador de Aprendizaje (PIA) | FIME UANL | Máquina Automatizada Híbrida

Diapositiva 15 de 15

Notes: NOTAS DEL ORADOR (SLIDE 15 - CONCLUSIONES Y DEMOS EN VIVO):
1. Conclusión de alto impacto: ExpendeX demuestra que con ingeniería mecatrónica de vanguardia, manufactura nacional y colaboración comunitaria es posible solucionar un problema real que afecta la salud de miles de estudiantes de FIME.
2. Dar paso inmediatamente a las demostraciones en vivo asignadas a cada especialista técnico:
- Emiliano presentará la compra en quiosco táctil con cobro QR dinámico y el panel admin FIFO.
- Samuel mostrará la maqueta CAD en Fusion 360 y la ejecución de tareas concurrentes en Wokwi.
- Francisco expondrá la conmutación de la matriz en EasyEDA y la medición del transitorio inductivo.
3. Agradecer al jurado y abrir formalmente la sesión de preguntas y respuestas.
