Anubys6/ExpendeX-Smart-Vending-FIME/03_ELECTRONICA_POTENCIA_EASYEDA/potencia.html

# ExpendeX® — Electrónica de Potencia & Matriz MOSFET 6×6 (36 Motores)

Esquemático Nativo EasyEDA Raspado de LCSC + Simulador SPICE de Conmutación High-Side / Low-Side

162 Componentes LCSC Reales

⬇ Descargar Archivo Nativo EasyEDA (.json) 🚀 Abrir EasyEDA Web Editor (https://easyeda.com/editor)

## 1. Simulador Interactivo de Conmutación 6×6

Haz clic en cualquier casilla (A1..F6) para activar su par de MOSFETs (Columna High-Side +24V y Fila Low-Side GND) y ver la ruta real de corriente:

Casilla Seleccionada

A1 (Comida Gigante)

Pines ESP32 Activos

IO33 (HIGH) / IO13 (LOW)

MOSFET High-Side (+24V)

Q_COL1 (IRF9540N: ON)

MOSFET Low-Side (GND)

Q_FILA_A (IRLZ44N: ON)

Corriente de Motor (24V)

1.85 A (44.4 W)

Protección Back-EMF

D_BLK_A1 + D_FLY_A1

## 2. Cómo Abrir en EasyEDA en 10 Segundos

Paso 1: Haz clic arriba en "Descargar Archivo Nativo EasyEDA (.json)".
Paso 2: Entra a easyeda.com/editor.
Paso 3: En el menú superior ve a File ➔ Open ➔ EasyEDA... y selecciona el archivo ExpendeX_Matriz_6x6_MOSFET_EasyEDA.json.
Paso 4: Para pasar a la placa PCB y vista 3D, haz clic en Design ➔ Convert Schematic to PCB.

## 3. BOM Oficial LCSC / JLCPCB (Raspado)

Ref | Componente | Encapsulado | LCSC ID | Cant
Q_FILA_A..F | IRLZ44NPBF (N-MOS) | TO-220-3 | C20755022 | 6
Q_COL1..6 | IRF9540NPBF (P-MOS) | TO-220-3 | C18187958 | 6
U_OPTO | PC817C Optoacoplador | SOP-4 / DIP-4 | C7472816 | 12
D_BLK / FLY | 1N4007 (1000V 1A) | SOD-123FL | C2988637 | 72
M_A1..F6 | Bornera Motor 5.08mm | CONN-2P | C42377752 | 37
U_BUCK_5V | LM2596S-5.0 Buck | TO-263-5 | C51820297 | 1
U1_ESP32 | ESP32-WROOM-32 | SMD Module | C6191506 | 1

⚡ Diagrama Esquemático Interactivo de Potencia: ■ Riel +24V High-Side | ■ Retorno Low-Side GND | ■ Columnas 1 y 6 = Espiral Gigante Comida Ruta Activa: +24V ➔ Q_COL1 (IRF9540N) ➔ D_BLK_A1 ➔ MOTOR A1 ➔ Q_FILA_A (IRLZ44N) ➔ GND
