Anubys6/ExpendeX-Smart-Vending-FIME/03_ELECTRONICA_POTENCIA_EASYEDA/Reporte_Tecnico_Electronica_Potencia_ExpendeX.html

🖨️ Imprimir / Guardar como PDF

# Reporte Técnico de Electrónica de Potencia

## Matriz MOSFET 6×6, Control de Compresor 30A & Diseño de PCB

Proyecto: ExpendeX Smart Vending Machine

Institución: Facultad de Ingeniería Mecánica y Eléctrica (FIME UANL)

Controlador: ESP32-WROOM-32 (IoT & Pasarela Mercado Pago)

Alimentación: 24 VDC @ 10A (Motores) + 120VAC / 24V (Compresor 1/5 HP)

Dimensiones PCB: 260 mm × 180 mm (2 Capas FR4, Cobre 1 oz)

Actuadores Totales: 36 Motores Espiral + 1 Compresor Hermético + Fan

### 1. Arquitectura del Sistema de Potencia e Integración del Compresor

El sistema de potencia de ExpendeX comprende dos subsistemas principales gobernados de forma centralizada por el microcontrolador ESP32:

1. Matriz Ortogonal 6×6 de Motores Dosificadores (24VDC): Multiplexa 36 motores mediante 12 transistores MOSFET (6 High-Side P-MOSFET IRF9540N y 6 Low-Side N-MOSFET IRLZ44N) con aislamiento galvánico de 5 kV por optoacopladores PC817C.
2. Etapa de Refrigeración (Cámara Fría 3.0°C - 5.5°C): Conmuta un compresor hermético de refrigeración de 1/5 HP (150W) accionado mediante un relé industrial de alta corriente de 30A / 250VAC (SLA-05VDC-SL-A), protegido por una red snubber RC de absorción de transitorios inductivos y monitoreado en lazo cerrado por una sonda digital 1-Wire DS18B20.

+24V BUS ──────────┬───────────────────┬───────────────────┬─── [6 Columnas P-MOSFET IRF9540N] │ (Q_COL1) │ (Q_COL2) │ [COL_1 Bus] [COL_2 Bus] [COL_3 Bus] │ │ │ [FILA_A Bus] ──(M_A1 + 1N4007)─────(M_A2 + 1N4007)─────(M_A3 + 1N4007) ... │ │ │ GND RETORNO ───────┴─[Q_ROW_A]─────────┴─[Q_ROW_B]─────────┴─── [6 Filas N-MOSFET IRLZ44N] ───────────────────────────────────────────────────────────────────────────────────────────── ETAPA DE REFRIGERACIÓN: 120VAC L ──[RELÉ 30A (SLA-05VDC)]──┬──(COMPRESOR 1/5 HP)── 120VAC N │ [SNUBBER 100Ω + 0.1μF] │ ESP32 IO2 ──[PC817C]──[2N2222A]──[BOBINA RELÉ + 1N4007] ESP32 IO5 ──[BUS 1-WIRE]─────────[SENSOR DIGITAL DS18B20 (3.0°C - 5.5°C)]

### 2. Red Snubber y Supresión de Arco en el Compresor

Al arrancar o apagar un compresor inductivo de refrigeración, se induce un sobrevoltaje significativo ($\Delta V = L \frac{di}{dt}$) que genera arco eléctrico entre las platinas del relé. Para garantizar una vida útil superior a 200,000 ciclos:

- Red Snubber RC: Se coloca en paralelo con los contactos normalmente abiertos (NO) una resistencia de $100\,\Omega$ (2W cerámico) en serie con un condensador de película de polipropileno metalizado de $0.1\,\mu\text{F}$ clase X2 (400V).
- Ranura de Aislamiento Galvánico (Creepage Slot): En el diseño de la placa PCB se fresó una ranura pasante sin cobre de $2.0\text{ mm}$ de ancho entre los contactos de alta tensión de 120VAC y las pistas lógicas de 5V/3.3V, garantizando una rigidez dieléctrica superior a 4,000 Vrms bajo norma IEC 60950.

### 3. Asignación Completa de Pines GPIO del ESP32

Señal Lógica | Pin ESP32 | Tipo / Etapa | Componente Físico | Función en Máquina
FILA_A .. F | IO13, 12, 14, 27, 26, 25 | Low-Side (GND) | IRLZ44NPBF + PC817C | Conmuta GND a Pisos 1 a 6
COL_1 .. 6 | IO33, 32, 23, 19, 17, 16 | High-Side (+24V) | IRF9540NPBF + PC817C | Inyecta +24V a Columnas 1 a 6
COMPRESOR | IO2 | Potencia AC/DC | Relé 30A (SLA-05VDC) + Opto | Enciende/Apaga Compresor Frío
TEMP_SENS | IO5 | Sensor 1-Wire | DS18B20 (Sonda Inox) | Monitoreo Térmico con Histéresis
DROP_SENSOR | IO4 | Digital Input | Barrera Infrarroja | Detección de Caída de Producto
LCD_I2C | IO21 (SDA), IO22 (SCL) | Bus I2C | LCD 1602 con Módulo PCF8574 | Mensajes de Pago y Temperatura

### 4. Lista de Materiales (BOM) con Números de Parte Oficiales JLCPCB / LCSC

Componente | Cant. | Encapsulado | Parámetros Relevantes | Código LCSC
IRLZ44NPBF | 6 | TO-220 | N-MOSFET 55V, 47A, Vgs(th)=1.0V-2.0V, Rds=0.022Ω | C75882
IRF9540NPBF | 6 | TO-220 | P-MOSFET -100V, -19A, Rds=0.117Ω | C2599
SLA-05VDC-SL-A | 1 | THT Power Relay | Relé de Potencia 30A 250VAC, Bobina 5VDC | C12586
PC817C | 13 | DIP-4 | Optoacoplador Galvánico Viso=5000Vrms | C76953
1N4007 | 73 | DO-41 | Diodo Rectificador 1000V 1A (72 Matriz + 1 Relé) | C64898
DS18B20 | 1 | TO-92 / Sonda | Sensor Digital de Temperatura 1-Wire ±0.5°C | C74426
LM2596S-5.0 | 1 | TO-263-5 | Regulador Reductor Conmutado 24V ➔ 5V 3A | C29781
Snubber RC (100Ω/0.1μF) | 1 | Radial 400V | Supresión de Arco Eléctrico para Compresor | C14872
Borneras Motor 5.08mm | 36 | CONN-2P | Conexión Rápida de 36 Motores de Espiral | C8584
Bornera Red 7.62mm | 1 | CONN-3P | Entrada de Alimentación Compresor (L, N, PE) | C9421

### 5. Especificaciones Físicas de la Placa PCB Generada

• Dimensiones de Placa: 260.0 mm × 180.0 mm (10.2" × 7.1")
• Material: FR-4 Doble Capa (Top Layer + Bottom Layer), Grosor 1.6 mm
• Espesor de Cobre: 1 oz (35 μm) con Plano de Masa y Bus de Potencia de 2.54 mm (100 mil)
• Aislamiento Galvánico: Ranura de fresado físico de 2.0 mm (Creepage distance de 4,000 Vrms)
• Disipación Térmica: Barra de aluminio común superior para los 12 transistores TO-220
• Montaje: 4 barrenos M3 en esquinas con conexión a tierra de chasis (PE)
