Anubys6/ExpendeX-Smart-Vending-FIME/01_DOCUMENTOS_ACADEMICOS_FIME/ExpendeX_Render_CAD_Detalle_Pantalla_10pulgadas.png

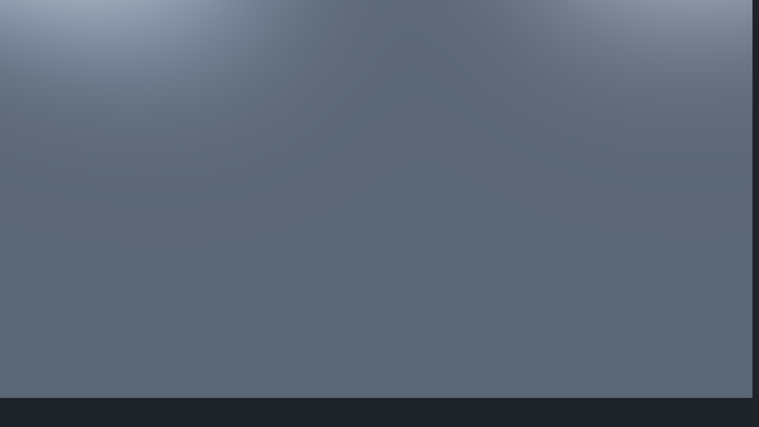
01_DOCUMENTOS_ACADEMICOS_FIME/ExpendeX_Render_CAD_Detalle_Pantalla_10pulgadas.png
