Anubys6/ExpendeX-Smart-Vending-FIME/01_DOCUMENTOS_ACADEMICOS_FIME/ExpendeX_Render_CAD_Isometrico_Derecho.png

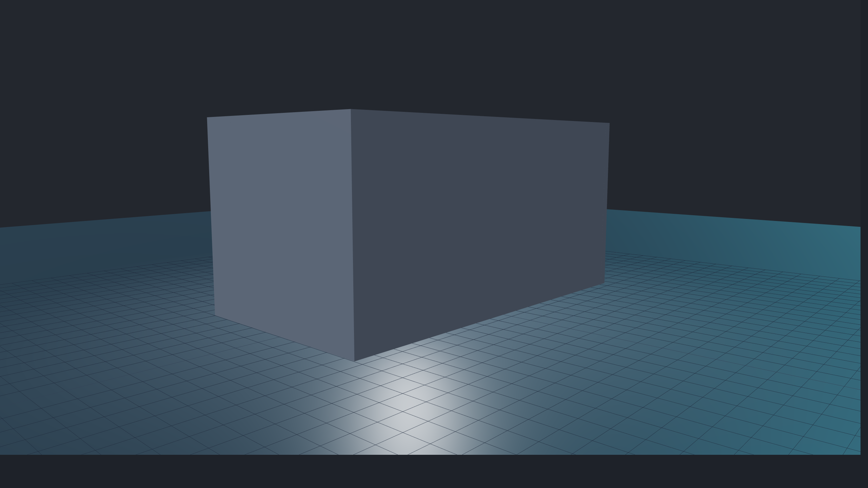
01_DOCUMENTOS_ACADEMICOS_FIME/ExpendeX_Render_CAD_Isometrico_Derecho.png
