Anubys6/ExpendeX-Smart-Vending-FIME/01_DOCUMENTOS_ACADEMICOS_FIME/ExpendeX_Render_Estudio_CAD_Oficial_1a1.png

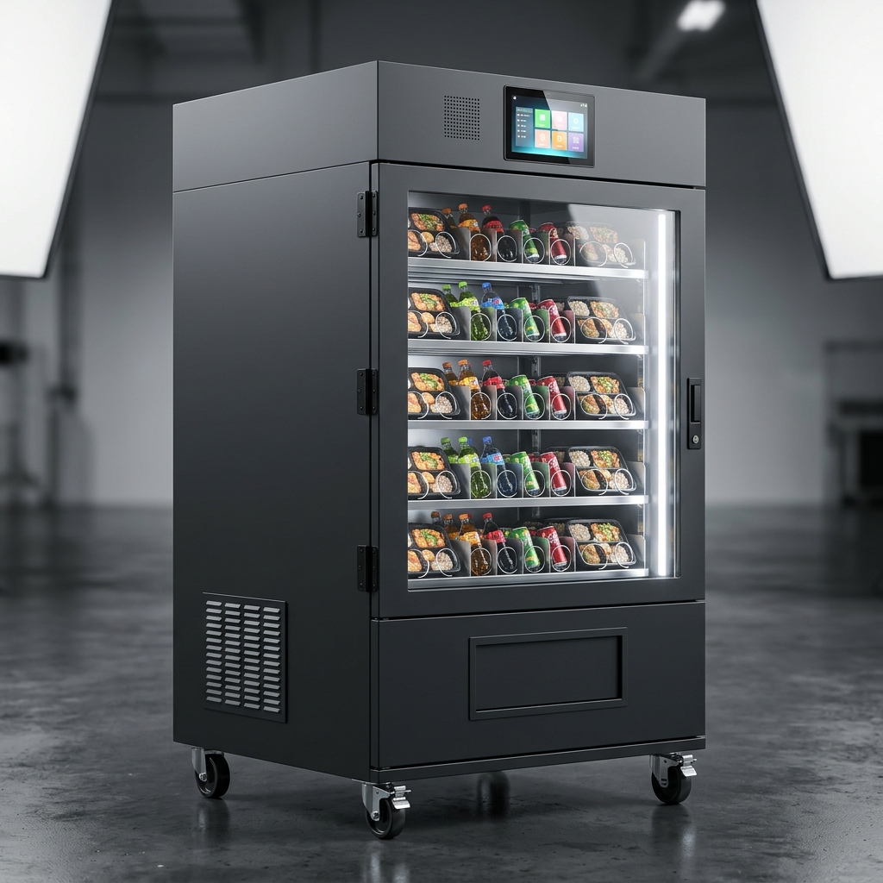
01_DOCUMENTOS_ACADEMICOS_FIME/ExpendeX_Render_Estudio_CAD_Oficial_1a1.png
