Anubys6/ExpendeX-Smart-Vending-FIME/01_DOCUMENTOS_ACADEMICOS_FIME/Img06_ExpendeX_Admin_Dashboard_Trimestral_90Dias_CurvaVentas.png

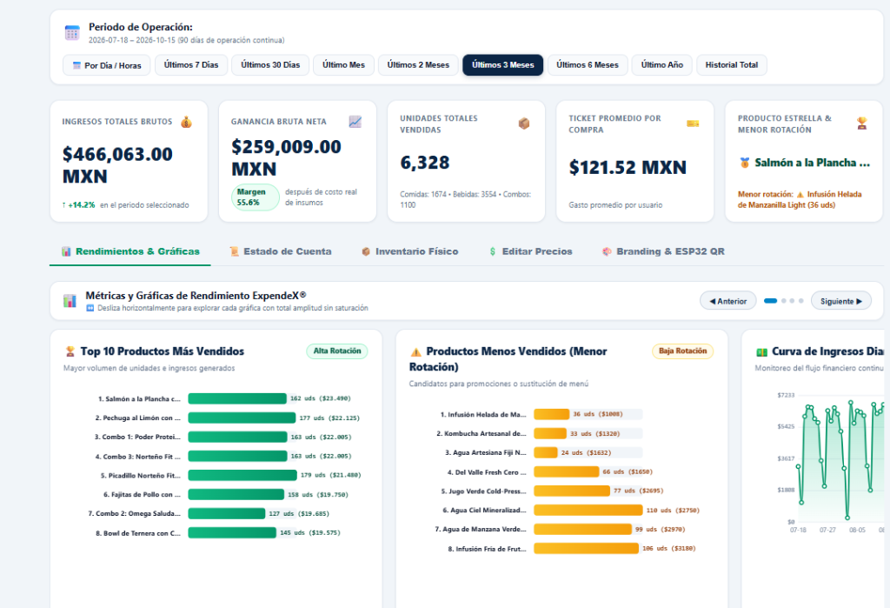
01_DOCUMENTOS_ACADEMICOS_FIME/Img06_ExpendeX_Admin_Dashboard_Trimestral_90Dias_CurvaVentas.png
