Anubys6/ExpendeX-Smart-Vending-FIME/02_MODELADO_3D_CAD/03_CAD_FUSION360_Y_AUTOCAD/Renders_Alta_Resolucion/cad_rear_isometric_structure.png

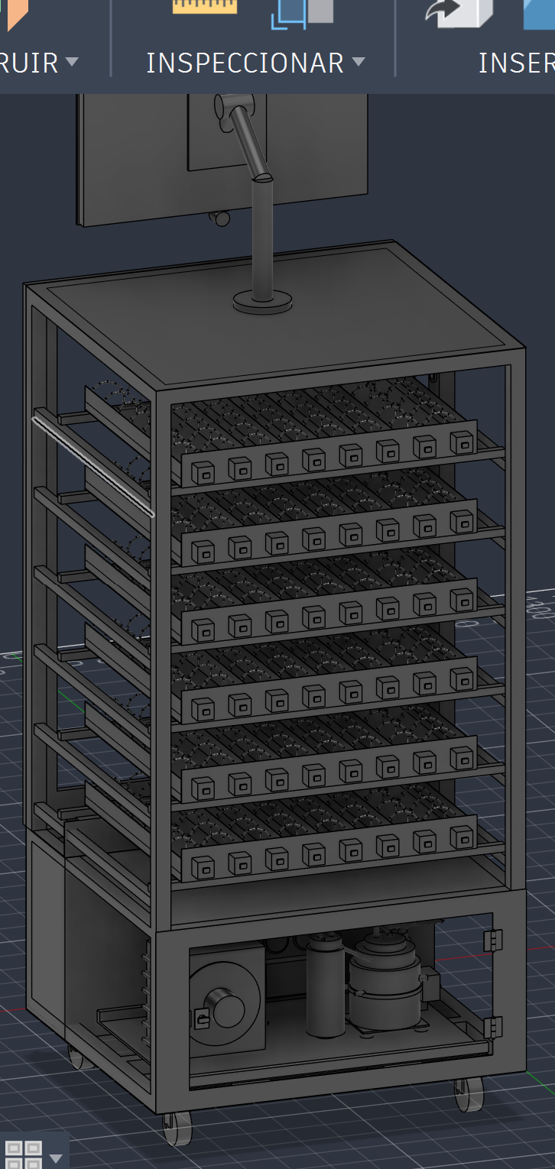
02_MODELADO_3D_CAD/03_CAD_FUSION360_Y_AUTOCAD/Renders_Alta_Resolucion/cad_rear_isometric_structure.png
