Anubys6/ExpendeX-Smart-Vending-FIME/02_MODELADO_3D_CAD/03_CAD_FUSION360_Y_AUTOCAD/Renders_Alta_Resolucion/cad_side_left_elevation.png

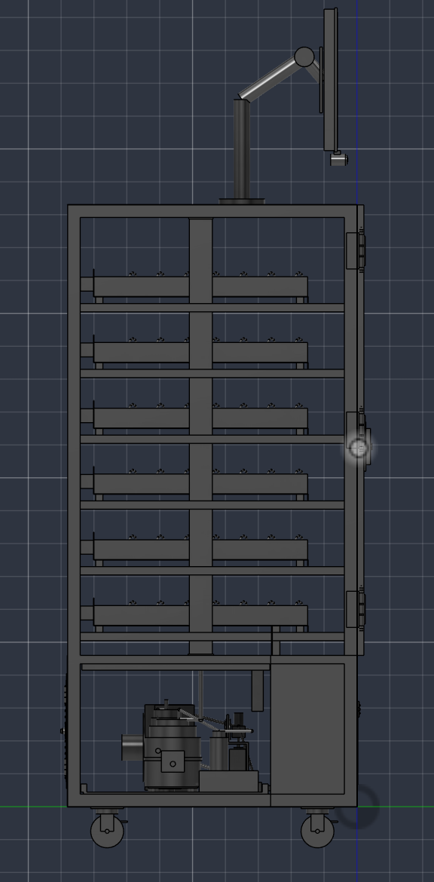
02_MODELADO_3D_CAD/03_CAD_FUSION360_Y_AUTOCAD/Renders_Alta_Resolucion/cad_side_left_elevation.png
