Anubys6/ExpendeX-Smart-Vending-FIME/04_FIRMWARE_ESP32_WOKWI/Screenshot_VSCode_Wokwi_Matriz_36_LEDs.png

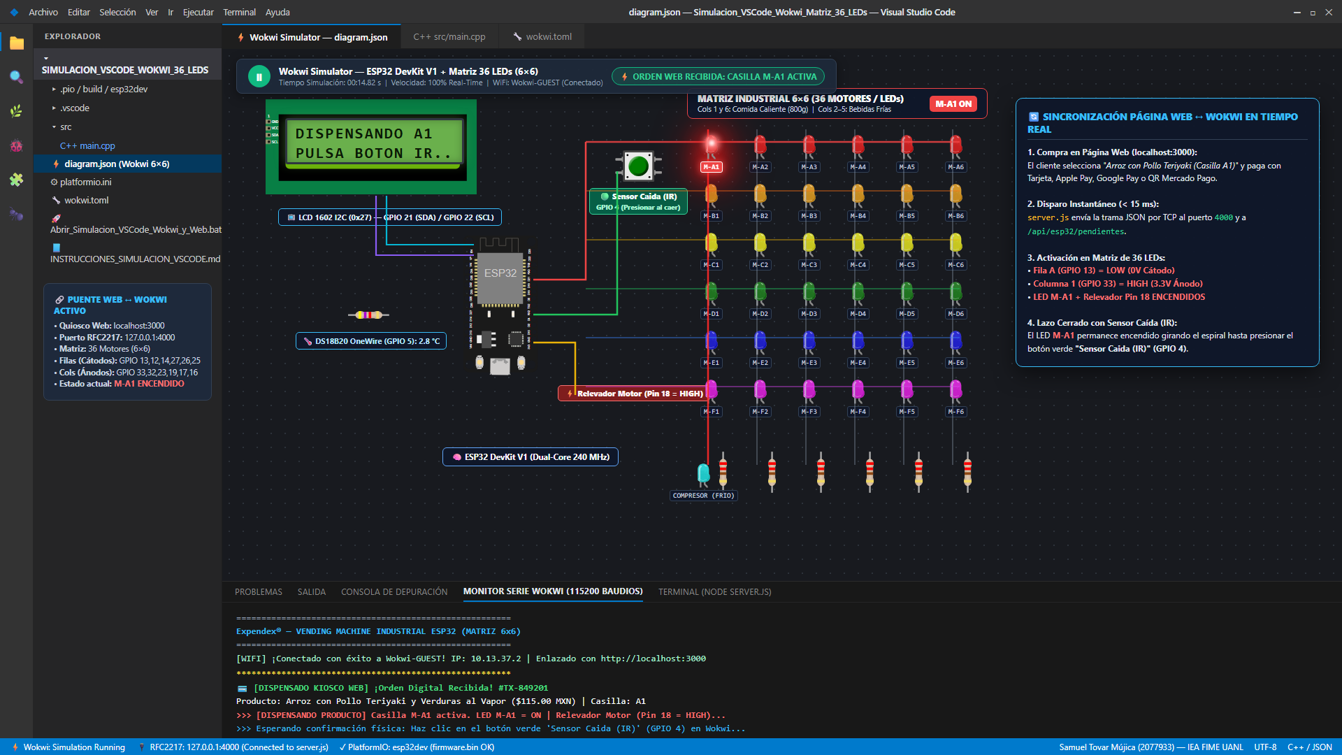
04_FIRMWARE_ESP32_WOKWI/Screenshot_VSCode_Wokwi_Matriz_36_LEDs.png
