Anubys6/ExpendeX-Smart-Vending-FIME/05_PLATAFORMA_WEB_DUAL/pagina_web_kiosco/images/agua_limon_chia.jpg

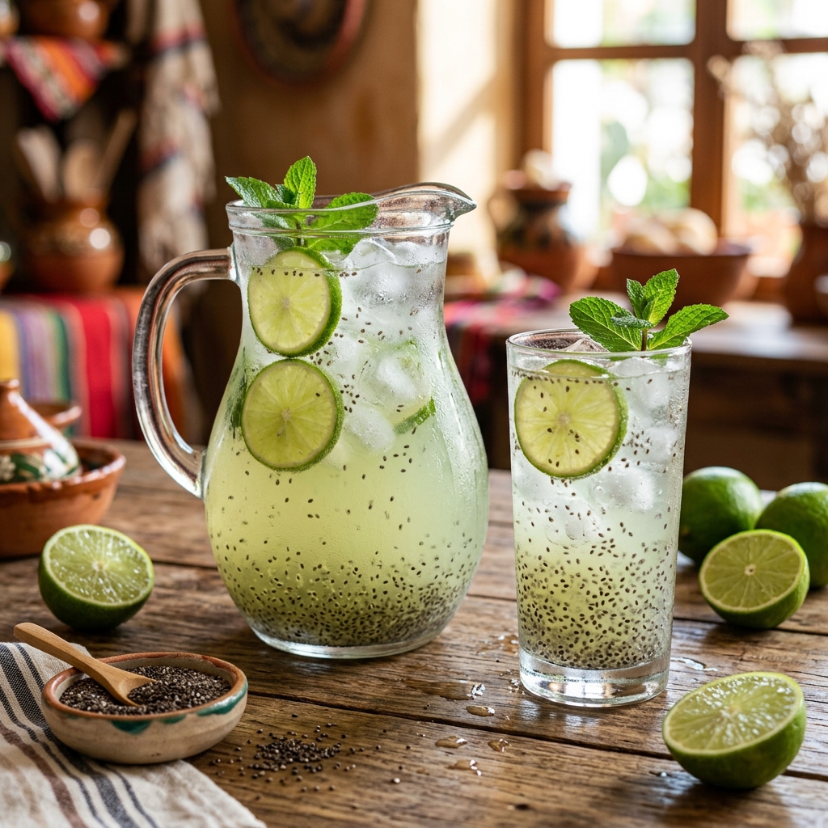
05_PLATAFORMA_WEB_DUAL/pagina_web_kiosco/images/agua_limon_chia.jpg
