Anubys6/ExpendeX-Smart-Vending-FIME/05_PLATAFORMA_WEB_DUAL/pagina_web_kiosco/images/ciel_exprim_jamaica.jpg

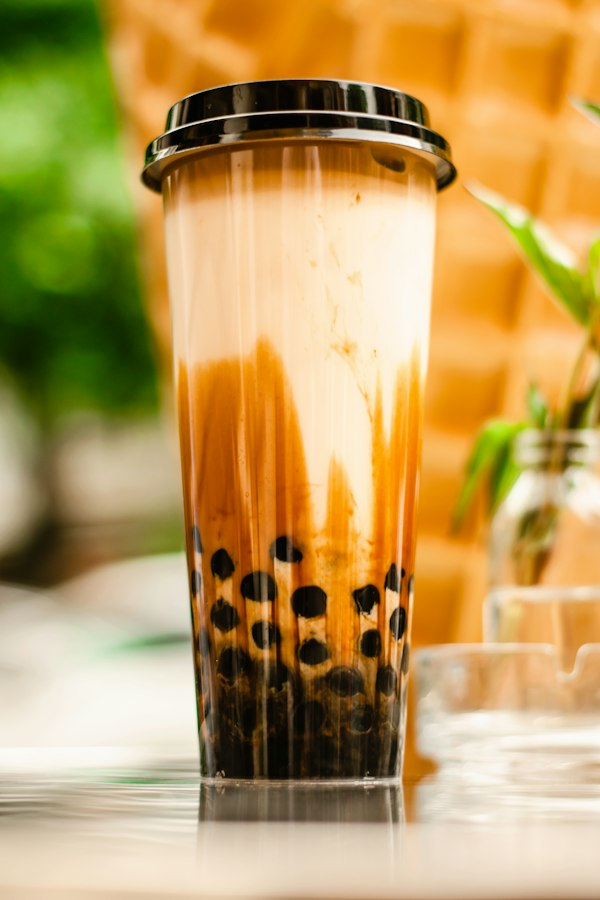
05_PLATAFORMA_WEB_DUAL/pagina_web_kiosco/images/ciel_exprim_jamaica.jpg
