Anubys6/ExpendeX-Smart-Vending-FIME/05_PLATAFORMA_WEB_DUAL/pagina_web_kiosco/images/combo_01_proteico.jpg

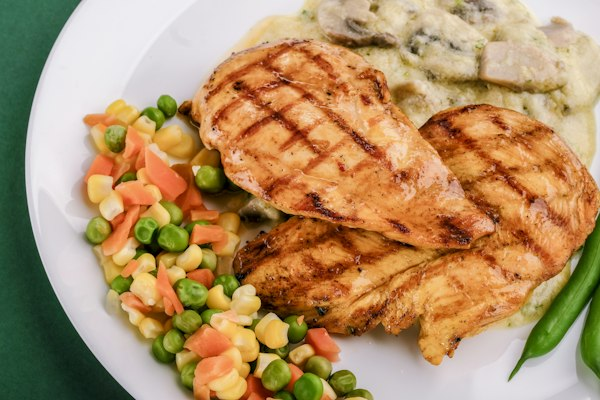
05_PLATAFORMA_WEB_DUAL/pagina_web_kiosco/images/combo_01_proteico.jpg
