Anubys6/ExpendeX-Smart-Vending-FIME/05_PLATAFORMA_WEB_DUAL/pagina_web_kiosco/images/combo_10_gourmet.jpg

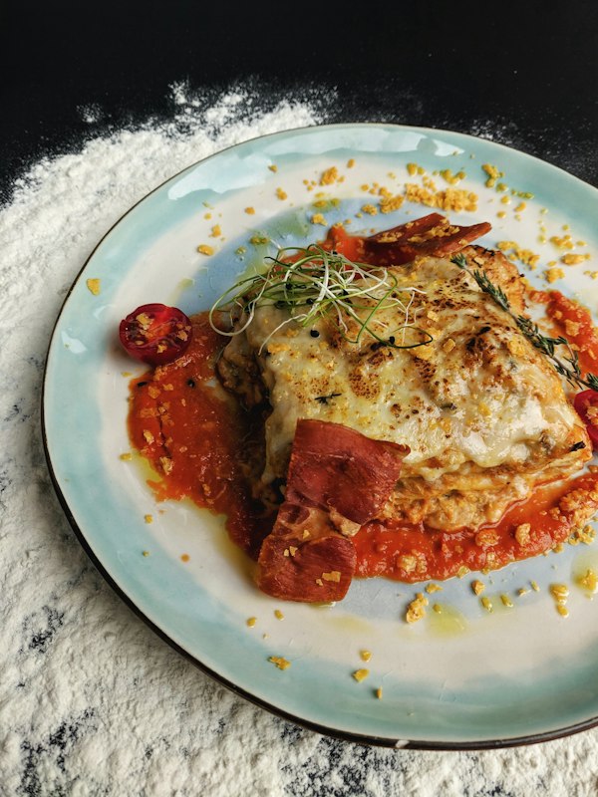
05_PLATAFORMA_WEB_DUAL/pagina_web_kiosco/images/combo_10_gourmet.jpg
