Anubys6/ExpendeX-Smart-Vending-FIME/05_PLATAFORMA_WEB_DUAL/pagina_web_kiosco/images/electrolit_zero.jpg

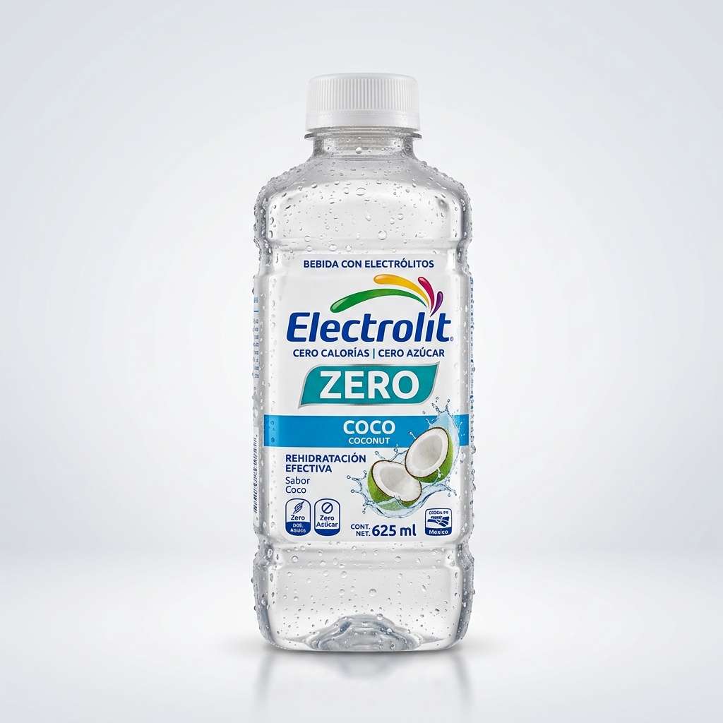
05_PLATAFORMA_WEB_DUAL/pagina_web_kiosco/images/electrolit_zero.jpg
