Anubys6/ExpendeX-Smart-Vending-FIME/05_PLATAFORMA_WEB_DUAL/user_interface_admin/images/combo_04_fajitas.jpg

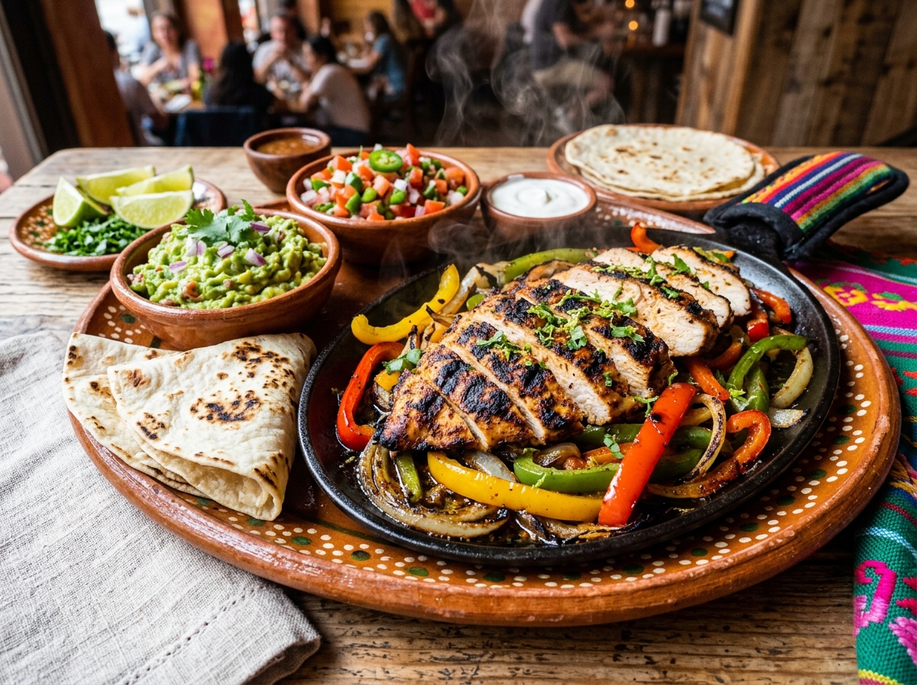
05_PLATAFORMA_WEB_DUAL/user_interface_admin/images/combo_04_fajitas.jpg
