Anubys6/ExpendeX-Smart-Vending-FIME/05_PLATAFORMA_WEB_DUAL/user_interface_admin/images/combo_08_mexicano.jpg

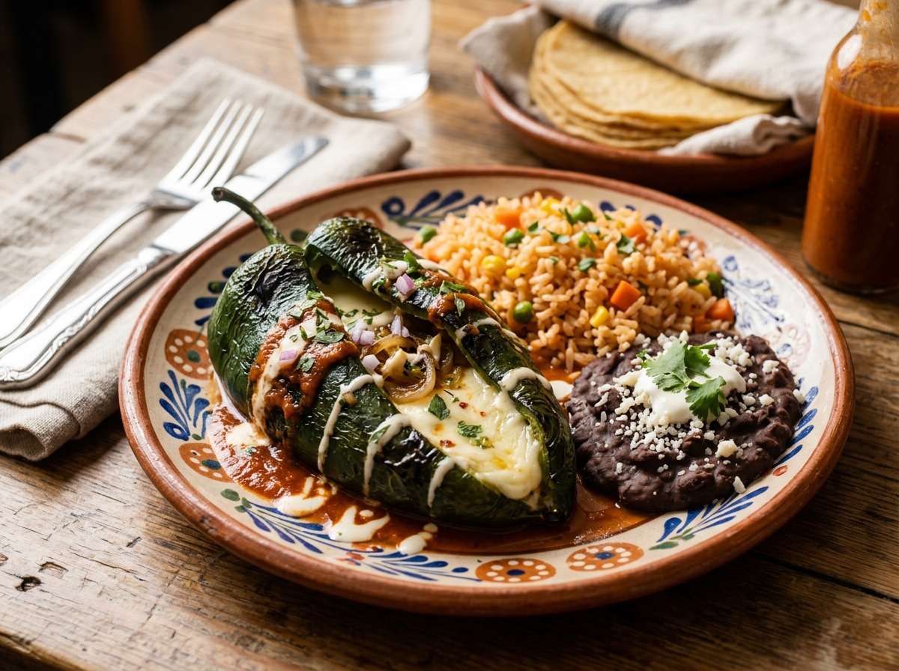
05_PLATAFORMA_WEB_DUAL/user_interface_admin/images/combo_08_mexicano.jpg
