Anubys6/ExpendeX-Smart-Vending-FIME/05_PLATAFORMA_WEB_DUAL/user_interface_admin/images/gatorade_zero.jpg

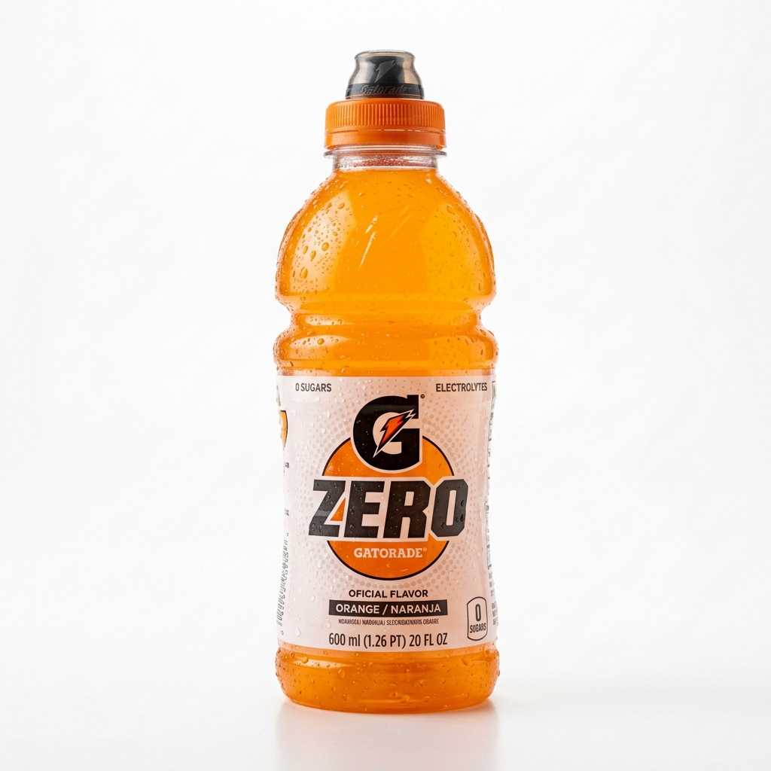
05_PLATAFORMA_WEB_DUAL/user_interface_admin/images/gatorade_zero.jpg
