Anubys6/ExpendeX-Smart-Vending-FIME/05_PLATAFORMA_WEB_DUAL/user_interface_admin/images/te_verde_comercial.jpg

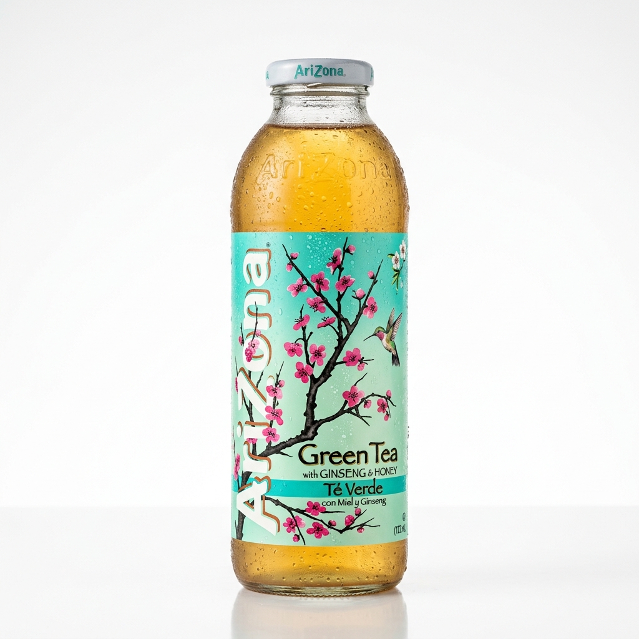
05_PLATAFORMA_WEB_DUAL/user_interface_admin/images/te_verde_comercial.jpg
