Anubys6/ExpendeX-Smart-Vending-FIME/05_PLATAFORMA_WEB_DUAL/user_interface_admin/images/topo_chico.jpg

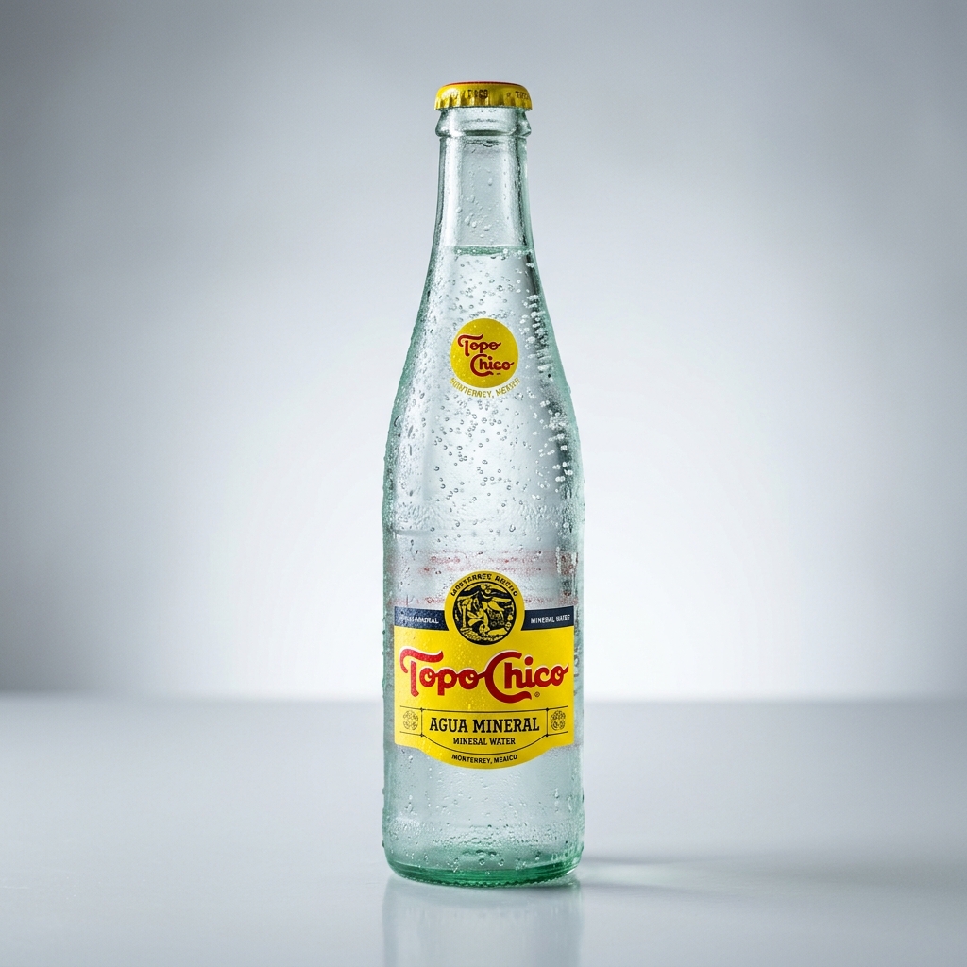
05_PLATAFORMA_WEB_DUAL/user_interface_admin/images/topo_chico.jpg
