Anubys6/ExpendeX-Smart-Vending-FIME/06_RENDERS_OFICIALES_Y_COMERCIALES/04_Vista_Isometrica_Posterior_Izquierda_CAD_Final.png

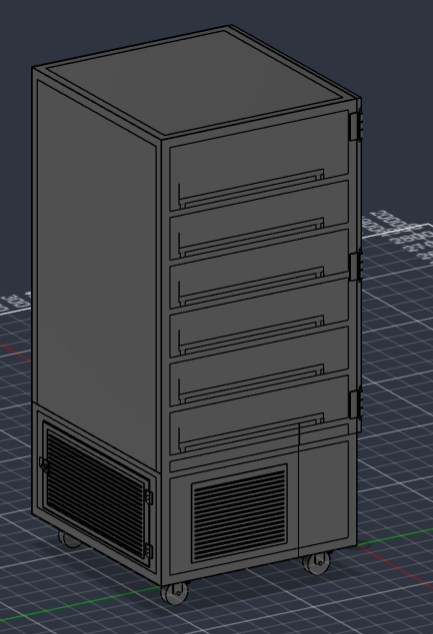
06_RENDERS_OFICIALES_Y_COMERCIALES/04_Vista_Isometrica_Posterior_Izquierda_CAD_Final.png
