Anubys6/ExpendeX-Smart-Vending-FIME/06_RENDERS_OFICIALES_Y_COMERCIALES/ExpendeX_Hero_Promocional.png

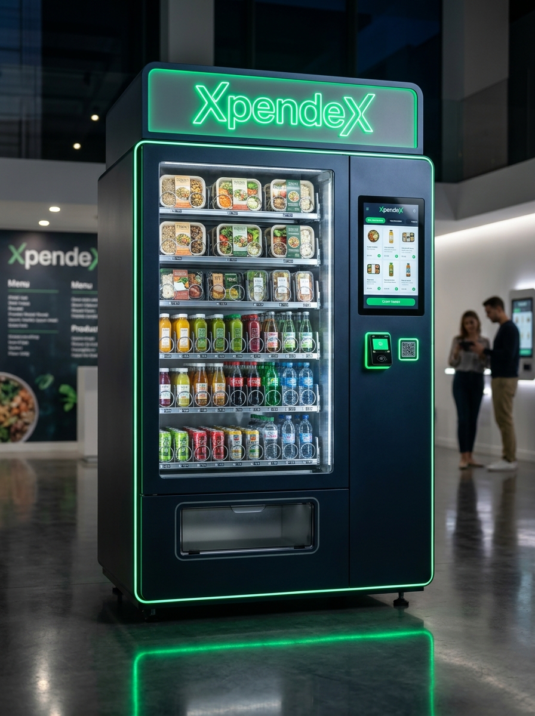
06_RENDERS_OFICIALES_Y_COMERCIALES/ExpendeX_Hero_Promocional.png
