Anubys6/ExpendeX-Smart-Vending-FIME/06_RENDERS_OFICIALES_Y_COMERCIALES/Img02_ExpendeX_Admin_Metricas_Rotacion_Top10.png

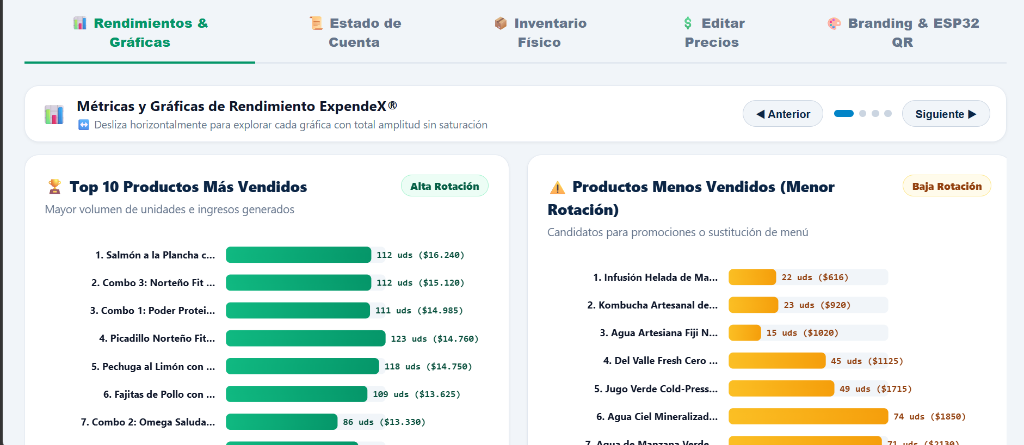
06_RENDERS_OFICIALES_Y_COMERCIALES/Img02_ExpendeX_Admin_Metricas_Rotacion_Top10.png
