Anubys6/ExpendeX-Smart-Vending-FIME/06_RENDERS_OFICIALES_Y_COMERCIALES/Promocionales/admin_dashboard_fifo.png

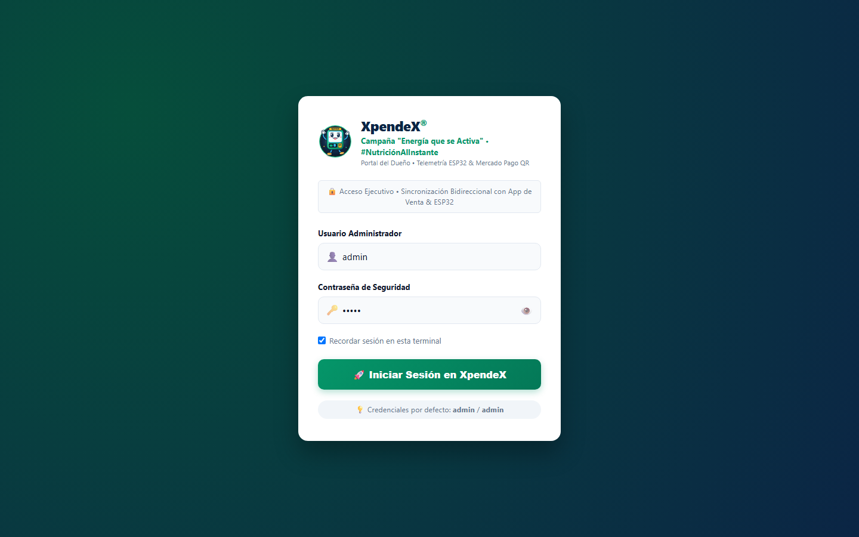
06_RENDERS_OFICIALES_Y_COMERCIALES/Promocionales/admin_dashboard_fifo.png
