Anubys6/ExpendeX-Smart-Vending-FIME/06_RENDERS_OFICIALES_Y_COMERCIALES/Promocionales/Expendex_Render_Comida_Cuadrada.png

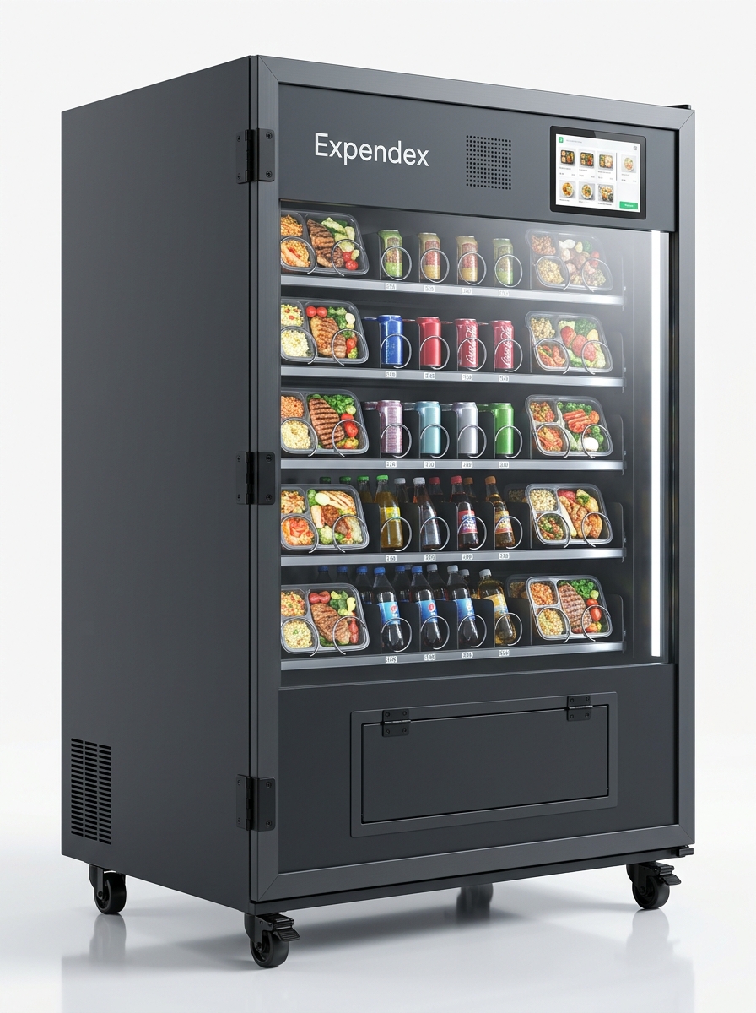
06_RENDERS_OFICIALES_Y_COMERCIALES/Promocionales/Expendex_Render_Comida_Cuadrada.png
