Anubys6/ExpendeX-Smart-Vending-FIME/03_ELECTRONICA_POTENCIA_EASYEDA/BOM_ExpendeX_Matriz_MOSFET_6x6_JLCPCB.csv

Comment | Designator | Footprint | LCSC Part # | Description | Quantity
IRLZ44NPBF-VB | Q_FILA_A,Q_FILA_B,Q_FILA_C,Q_FILA_D,Q_FILA_E,Q_FILA_F | TO-220-3_L10.0-W4.5-P2.54-L-2 | C20755022 | MOSFET N-Channel 55V 47A Logic-Level Low-Side Row Driver | 6
IRF9540NPBF-JSM | Q_COL1,Q_COL2,Q_COL3,Q_COL4,Q_COL5,Q_COL6 | TO-220-3_L10.2-W4.6-P2.54-L | C18187958 | MOSFET P-Channel 100V 23A High-Side +24V Column Driver | 6
PC817C-MS | U_OPTO_C1,U_OPTO_C2,U_OPTO_C3,U_OPTO_C4,U_OPTO_C5,U_OPTO_C6,U_OPTO_FA,U_OPTO_FB,U_OPTO_FC,U_OPTO_FD,U_OPTO_FE,U_OPTO_FF | SOP-4_L6.5-W4.6-P2.54-LS10.0 | C7472816 | Optoacoplador Aislamiento Galvanico 5kV 3.3V->24V | 12
1N4007(A7) | D_BLK_A1..D_BLK_F6, D_FLY_A1..D_FLY_F6 | SOD-123FL_L2.8-W1.8-LS3.7-RD | C2988637 | Diodos de Bloqueo Anti-Ghosting (36) + Diodos Flyback Back-EMF (36) | 72
WJ500V-5.08-2P-13-00A | J_PWR_24V, M_A1..M_F6 | CONN-TH_2P-P5.08-WJ500V-5.08-2P | C42377752 | Bornera Industrial 5.08mm 2 Pines (1 Entrada 24V + 36 Salidas Motores) | 37
330R 1% | R_LED_C1..C6, R_LED_FA..FF | R0805 | C17630 | Resistencia Limitadora LED Optoacoplador 330 Ohm | 12
10kR 0.1% | R_PU_C1..C6, R_PD_A..F | R0805 | C17414 | Resistencia Pull-Up (+24V P-MOS) y Pull-Down (GND N-MOS) 10k Ohm | 12
LM2596S-5.0TO | U_BUCK_5V | PG-TO-263-5_L10.0-W9.0-P1.70-LS15.0-TL | C51820297 | Regulador Step-Down DC-DC 24V a 5V 3A para Logica y ESP32 | 1
1000uF 35V | C_BULK_24V, C_OUT_5V | CAP-SMD_BD8.0-L8.3-W8.3 | C2841963 | Capacitores Electroliticos de Filtrado Riel 24V y 5V | 2
ESP32-WROOM-32 (16MB) | U1_ESP32 | WIFIM-SMD_ESP32-WROOM-32-N4 | C6191506 | Microcontrolador Wi-Fi + Bluetooth Controlador Matriz 6x6 | 1
