Anubys6/ExpendeX-Smart-Vending-FIME/02_MODELADO_3D_CAD/02_MODELOS_3D_OBJ_STL_3MF/ExpendeX_Vending_Miniatura_Bambu_MakerWorld_Escala_1a10.3mf

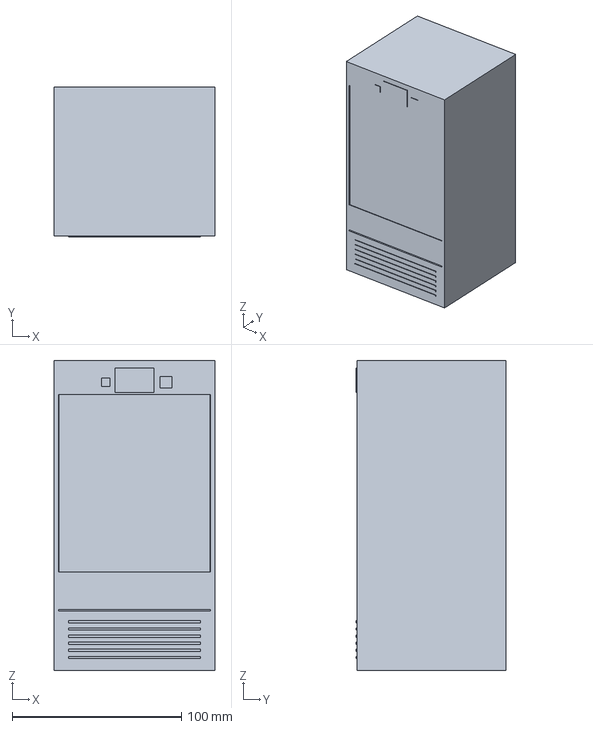
[picture p102: CAD file, 2026-10-23]
02_MODELADO_3D_CAD/02_MODELOS_3D_OBJ_STL_3MF/ExpendeX_Vending_Miniatura_Bambu_MakerWorld_Escala_1a10.3mf
95.0 x 88.5 x 183.0 mm
