Anubys6/ExpendeX-Smart-Vending-FIME/02_MODELADO_3D_CAD/03_CAD_FUSION360_Y_AUTOCAD/Proyecto_ExpendeX_AutoCAD.dxf

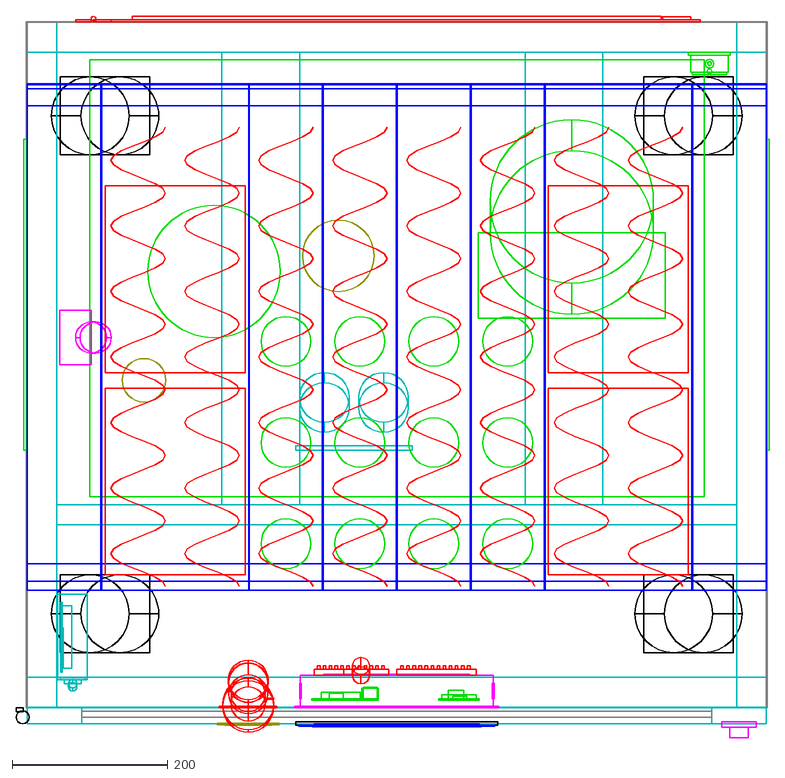
[picture p103: CAD file, 2026-10-23]
02_MODELADO_3D_CAD/03_CAD_FUSION360_Y_AUTOCAD/Proyecto_ExpendeX_AutoCAD.dxf
968.0 x 926.9
