Anubys6/ExpendeX-Smart-Vending-FIME/02_MODELADO_3D_CAD/02_MODELOS_3D_OBJ_STL_3MF/ExpendeX_Vending_Machine_Oficial.obj

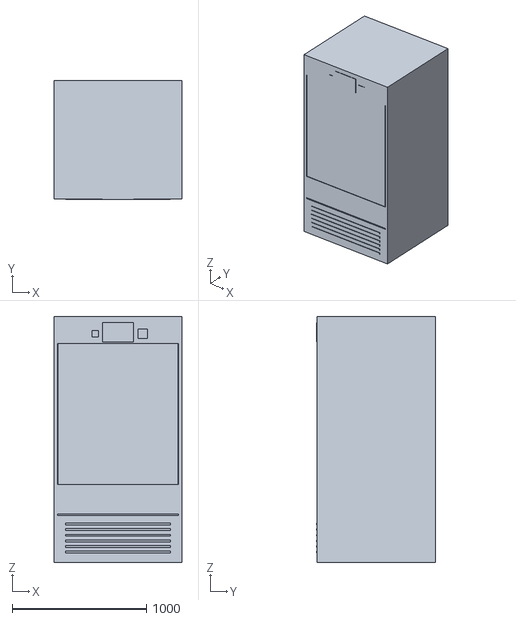
[picture p104: CAD file, 2026-10-23]
02_MODELADO_3D_CAD/02_MODELOS_3D_OBJ_STL_3MF/ExpendeX_Vending_Machine_Oficial.obj
950.0 x 885.0 x 1830.0
