Anubys6/ExpendeX-Smart-Vending-FIME/02_MODELADO_3D_CAD/03_CAD_FUSION360_Y_AUTOCAD/Proyecto_Expandex_2_AutoCAD.dxf

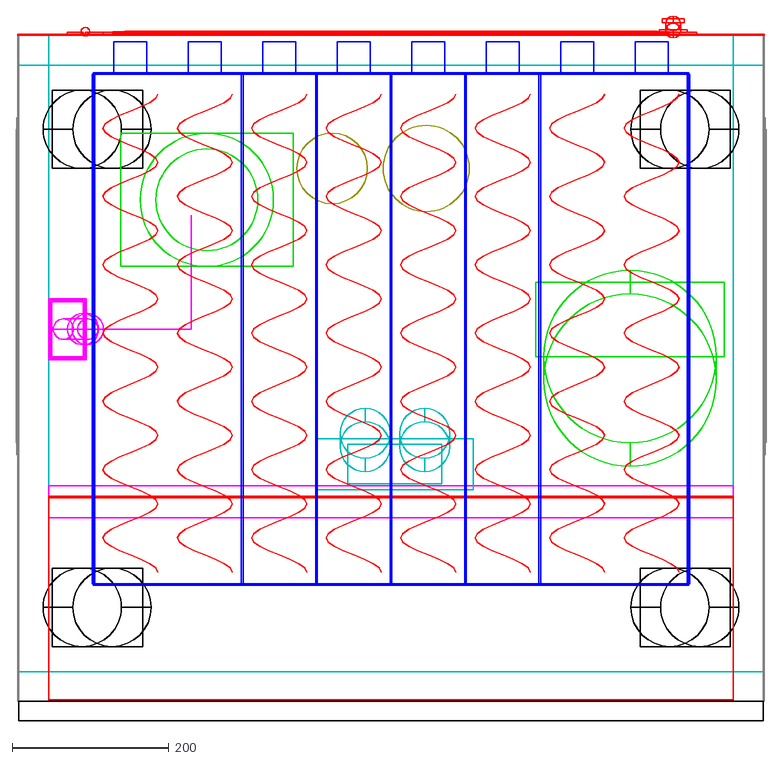
[picture p106: CAD file, 2026-10-23]
02_MODELADO_3D_CAD/03_CAD_FUSION360_Y_AUTOCAD/Proyecto_Expandex_2_AutoCAD.dxf
957.0 x 899.5
