Anubys6/ExpendeX-Smart-Vending-FIME/02_MODELADO_3D_CAD/02_MODELOS_3D_OBJ_STL_3MF/ExpendeX_Espiral_Vending_Resorte_Individual_Funcional_1a1.3mf

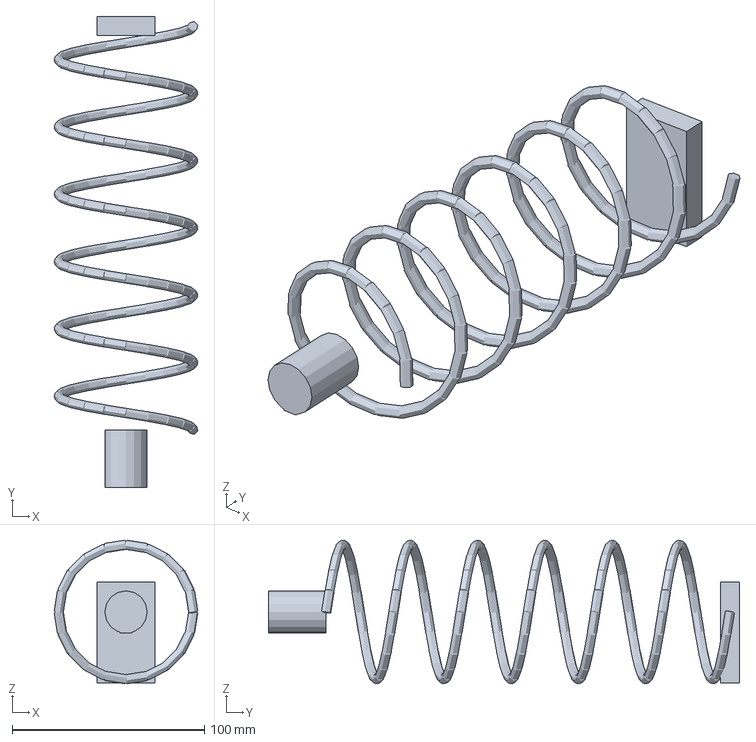
[picture p107: CAD file, 2026-10-23]
02_MODELADO_3D_CAD/02_MODELOS_3D_OBJ_STL_3MF/ExpendeX_Espiral_Vending_Resorte_Individual_Funcional_1a1.3mf
74.7 x 245.0 x 74.7 mm
