Anubys6/ExpendeX-Smart-Vending-FIME/(list of files, cad)

Other CAD files:
02_MODELADO_3D_CAD/02_MODELOS_3D_OBJ_STL_3MF/ExpendeX_Vending_Miniatura_Escala_1a10_Impresion3D.stl
02_MODELADO_3D_CAD/02_MODELOS_3D_OBJ_STL_3MF/ExpendeX_Vending_Machine_Modelo_Completo_1a1.stl
02_MODELADO_3D_CAD/02_MODELOS_3D_OBJ_STL_3MF/ExpendeX_Vending_Machine_BambuLab_MakerWorld.3mf
02_MODELADO_3D_CAD/02_MODELOS_3D_OBJ_STL_3MF/ExpendeX_Espiral_Vending_Resorte_Individual_Funcional_1a1.stl
02_MODELADO_3D_CAD/02_MODELOS_3D_OBJ_STL_3MF/ExpendeX_Vending_Machine_Modelo_Completo_1a1.obj
