Anubys6/ExpendeX-Smart-Vending-FIME/(list of files, drawings)

Other design files:
03_ELECTRONICA_POTENCIA_EASYEDA/ExpendeX_Matriz_6x6_MOSFET_EasyEDA.json
03_ELECTRONICA_POTENCIA_EASYEDA/PCB_ExpendeX_Matriz_6x6_MOSFET_Compresor.json
03_ELECTRONICA_POTENCIA_EASYEDA/SCH_ExpendeX_Matriz_6x6_MOSFET_Compresor.json
