Anubys6/ExpendeX-Smart-Vending-FIME/(commit log)

2026-10-23 fix(readme): reemplazar render por modelo real 3D gris con pantalla superior de 10.1 pulgadas
2026-10-23 docs: actualizar badge de acceso abierto via enlace y mente colmena
2026-10-23 docs: citar formalmente el Programa de Evidencias de Aprendizaje de la U.A. Proyecto de Ingenieria Aplicada (IEAI) y acceso abierto via link en todas las AFs
2026-10-24 feat: actualizar presentacion con modelo CAD oficial real y ciclo de funcionamiento paso a paso
2026-10-24 feat(presentacion): diseno organico basado en retos de ingenieria, modelo CAD real y validacion experimental
2026-10-24 feat: Hub interactivo para GitHub Pages de ExpendeX FIME
2026-10-26 docs: reincorporar a Francisco Reyes Santiago en portadas, tablas y diapositiva inicial con division equilibrada de carga tecnica
2026-10-26 feat(pages): portal interactivo de documentos FIME y visor web online completo de AF5 Marco Teorico con imagenes y tablas
2026-10-28 feat(presentacion): sincronizacion integral de diapositivas con notas de orador, graficos analiticos, autorias tecnicas y asignacion de demostraciones en vivo
2026-10-28 fix(presentacion): maquina vertical sin distorsion, benchmarking 20 min cafeteria, termino maquina automatizada hibrida y diseno bento de 3 columnas sin encimado
2026-10-28 style(portadas): portada ocupa pagina 1 completa con salto a pagina 2 para indice y contenido
2026-10-29 style(portadas): retirar texto redundante del medio en portadas (diseno de experimentos de la maquina)
2026-10-29 refactor(bom): mover enlaces de compra a referencias bibliograficas IEEE y limpiar tablas BOM
2026-10-29 refactor(docs): eliminar anexos redundantes y conservar el cuerpo principal esencial en AF3, AF4 y AF5
2026-10-30 security: sanitizar credenciales de pago, agregar soporte .env y blindar .gitignore
