Anubys6/ExpendeX-Smart-Vending-FIME/(notices)

Notices in the files:
README.md:
License: MIT
